mgyee/engn1600-team1/CAD5/README

### Group members
Matthias Yee, Alex Wang, Ray Wu, Martin Atilla, Kelvin Amankwaa

### Entire design workspace, including layouts and testbenches.
The main layout is `shifter.gds`. The main schematic is `shifter.sch`. We have four main testbenches:
- `shifter_tb.sch` for pre-PEX functionality checking
- `shifter_delay_tb.sch` for pre-PEX timing
- `shifter_postpex_tb.sch` for post-PEX functionality checking
- `shifter_postpex_delay_tb.sch` for post-PEX timing
In addition, we utilized the following testbench for sizing simulation: 
- `shifter_sizing_tb.sch`

### Testbenches
We used `generate.py` to convert a list of tests into input PWL stimuli. For output, we used Xschem graphs within the schematic to parse bus signals. Thus, we verify functionality using a more compact representation than per-input waveforms.

The results are in `SUBMIT/prepex/shifter_tb.svg` and `SUBMIT/postpex/shifter_postpex_tb.svg`. We simulate all shifts of `0x00AA` with resets in between to identify rise and fall time.

```
** TEST SUMMARY
** 00: 0x00AA << (0 ? 00 : 00) = 0x00AA
** 01: 0x00AA << (1 ? 00 : 00) = 0x00AA
** 02: 0x00AA << (0 ? 00 : 01) = 0x0154
** 03: 0x00AA << (1 ? 00 : 01) = 0x00AA
** 04: 0x00AA << (0 ? 00 : 02) = 0x02A8
** 05: 0x00AA << (1 ? 00 : 02) = 0x00AA
** 06: 0x00AA << (0 ? 00 : 03) = 0x0550
** 07: 0x00AA << (1 ? 00 : 03) = 0x00AA
** 08: 0x00AA << (0 ? 00 : 04) = 0x0AA0
** 09: 0x00AA << (1 ? 00 : 04) = 0x00AA
** 10: 0x00AA << (0 ? 00 : 05) = 0x1540
** 11: 0x00AA << (1 ? 00 : 05) = 0x00AA
** 12: 0x00AA << (0 ? 00 : 06) = 0x2A80
** 13: 0x00AA << (1 ? 00 : 06) = 0x00AA
** 14: 0x00AA << (0 ? 00 : 07) = 0x5500
** 15: 0x00AA << (1 ? 00 : 07) = 0x00AA
** 16: 0x00AA << (0 ? 00 : 08) = 0xAA00
** 17: 0x00AA << (1 ? 00 : 08) = 0x00AA
** 18: 0x00AA << (0 ? 00 : 09) = 0x5400
** 19: 0x00AA << (1 ? 00 : 09) = 0x00AA
** 20: 0x00AA << (0 ? 00 : 10) = 0xA800
** 21: 0x00AA << (1 ? 00 : 10) = 0x00AA
** 22: 0x00AA << (0 ? 00 : 11) = 0x5000
** 23: 0x00AA << (1 ? 00 : 11) = 0x00AA
** 24: 0x00AA << (0 ? 00 : 12) = 0xA000
** 25: 0x00AA << (1 ? 00 : 12) = 0x00AA
** 26: 0x00AA << (0 ? 00 : 13) = 0x4000
** 27: 0x00AA << (1 ? 00 : 13) = 0x00AA
** 28: 0x00AA << (0 ? 00 : 14) = 0x8000
** 29: 0x00AA << (1 ? 00 : 14) = 0x00AA
** 30: 0x00AA << (0 ? 00 : 15) = 0x0000
** 31: 0x00AA << (1 ? 00 : 15) = 0x00AA
```

See `SUBMIT/prepex/shifter_delay_tb.svg` or `SUBMIT/postpex/shifter_postpex_delay_tb.svg` for a demonstration of the critical path input we tested. In summary, we used an input whose critical path must traverse both R/I selection and all logarithmic shift stages before toggling the output. We tested both directions (rising and falling). In addition, `SUBMIT/prepex/shifter_delay.svg` monitors internal signals. Driving the SX lines takes a fair amount of time due to high capacitance.

```
** TEST SUMMARY
** 0x0001 << E -> 0x0001 << F -> 0x0001 << E
```

We get a pre-PEX rise time of **529.0 ps** and fall time of **541.4 ps**.

We get a post-PEX rise time of **1510.0 ps** and fall time of **1411.1 ps**.

The discrepancy likely arises since we did not simulate wire capacitance.

### Design
Before sizing, we tested four mux designs for the main shifter logic:

- Pure CMOS mux
- Pure CMOS mux with inversion between each stage (the design more naturally gives inverted outputs)
- Pure CMOX mux with inversion between each stage and gates to replace those with hardcoded inputs
- Transmission gate CMOS mux with inversion at the start and end for level restoration

The transmission gate variation was ultimately fastest and interfaces well with inverted RF inputs. Other designs suffered from high capacitance on the SX nodes.

For `S[3..0]` selection logic, we use a stack of 2x1 muxes to select between `R[3..0]` when SEL=0 and `I[3..0]` when SEL=1. We decided to use pure CMOS muxes instead of transmission gate muxes here since they are amenable to sizing and provide inverting outputs.

### Notes on sizing
- We just went with 1x sizing for `2x1_mux.sch`.
- Technically, we should size the S0, S1, S2, and S3 muxes differently since they lie later and later along the critical path, but we sized them together for simplicity.
- Ultimately, we iteratively sized kY, kYb = kI, and kSELb. kSELb is unbounded (the bigger the better) since we assert SEL without accounting for input capacitance. We limited kSELb to 6.
- To sweep sizes, we just exchanged the commenting on lines 326-329 of `shifter_sizing_tb.sch`.
- The testbench uses dummy transistors to estimate the load on each SX node.
