mgyee/engn1600-team1/CAD4/README

NB: We originally submitted what we had under Matthias. This submission is updated with the finalized layout and post-PEX analysis. I'll ask him to resubmit as well when he's available.

### Group members
Matthias Yee, Alex Wang, Ray Wu, Martin Atilla, Kelvin Amankwaa

### Entire design workspace, including layouts and testbenches.
The main layout is `alu.gds`. The main schematic is `alu.sch`. We have four main testbenches:
- `alu_tb.sch` for pre-PEX functionality checking
- `alu_delay_tb.sch` for pre-PEX timing
- `alu_postpex_tb.sch` for post-PEX functionality checking
- `alu_postpex_delay_tb.sch` for post-PEX timing

See `SUBMIT/ALU_main_drc.png`, `SUBMIT/ALU_antenna_drc.png`, and `SUBMIT/ALU_lvs.png` for DRC and LVS passing.

### Screenshots of at least the 6 tests mentioned in the Logic Verification section above.
We used `generate.py` to convert a list of tests into input PWL stimuli. For output, we used Xschem graphs within the schematic to parse bus signals. The results are in `SUBMIT/prepex/alu_tb.svg` and `SUBMIT/postpex/alu_postpex_tb.svg`.

### Screenshots of the simulated propagation delay.
See `SUBMIT/prepex/alu_delay_tb.svg` or `SUBMIT/postpex/alu_postpex_delay_tb.svg` for a demonstration of the inputs we tested. In summary, we used an input such that a change at the LSB of B would cause all COUTs to flip. We tested both directions (rising and falling). In addition, `SUBMIT/prepex/alu_delay.svg` monitors internal signals. Delay is roughly equal between FAs and MUXes.

We get a pre-PEX rise time of **1.748 ns** and fall time of **1.760 ns**.

We get a post-PEX rise time of **2.962 ns** and fall time of **3.016 ns**.

### A hand drawn drawing, annotating the critical path of this design.
See `SUBMIT/ENGN 1600 CAD4 CRIT.pdf`. With carry select, the critical path goes through the first set of full adders and then the 2x1 MUXes between subsequent 4-bit sets.
