mgyee/engn1600-team1/CAD3/SUBMIT/postpex/spice_rf_clk->we0clkdelay.png

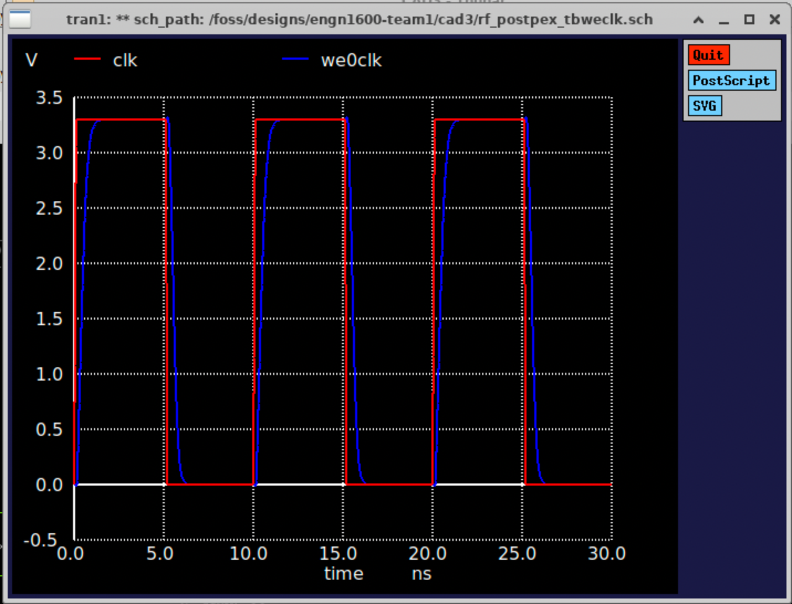
CAD3/SUBMIT/postpex/spice_rf_clk->we0clkdelay.png
