mgyee/engn1600-team1/CAD3/SUBMIT/RF_antenna_drc.png

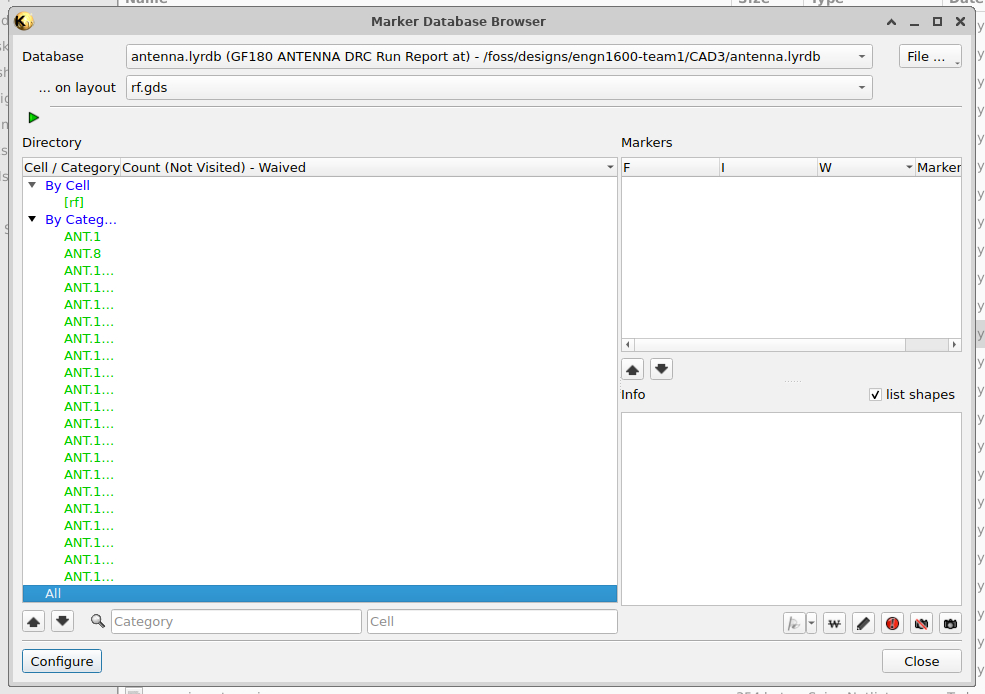
CAD3/SUBMIT/RF_antenna_drc.png
