mgyee/engn1600-team1/CAD3/SUBMIT/RF_lvs.png

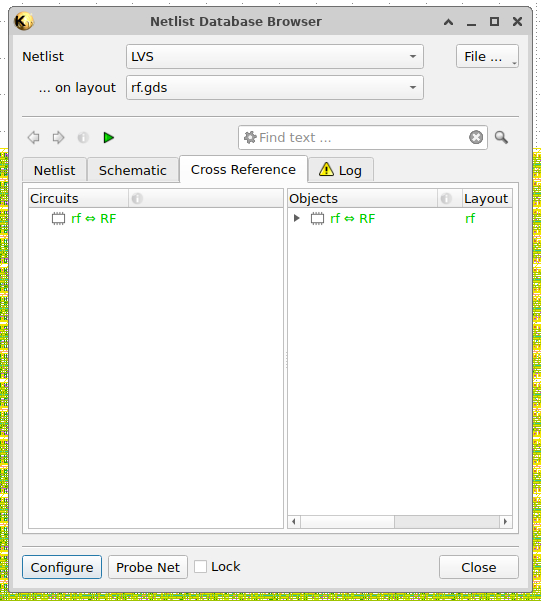
CAD3/SUBMIT/RF_lvs.png
