mgyee/engn1600-team1/CAD4/SUBMIT/ALU_antenna_drc.png

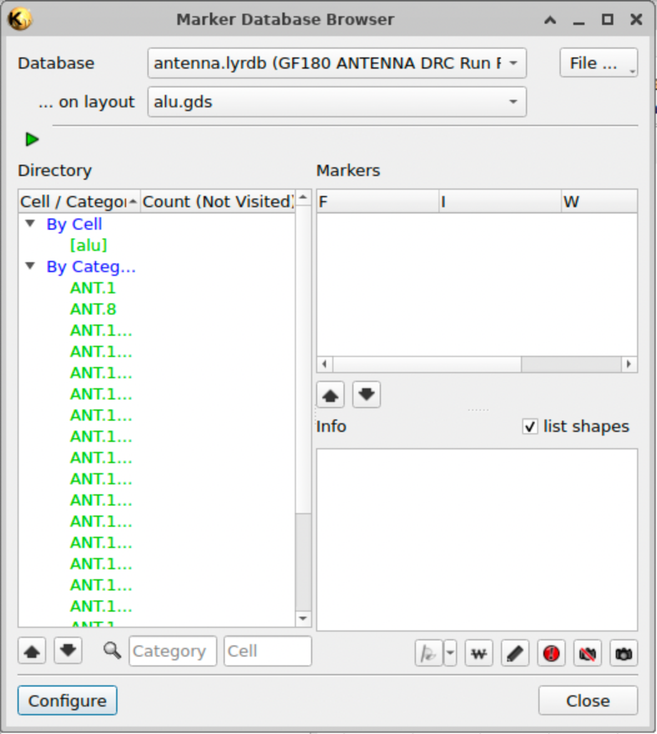
CAD4/SUBMIT/ALU_antenna_drc.png
