mgyee/engn1600-team1/CAD4/SUBMIT/ALU_lvs.png

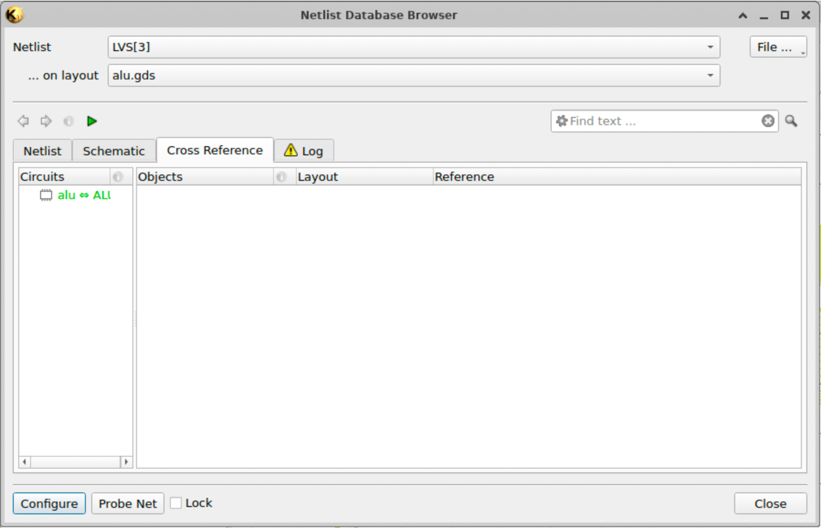
CAD4/SUBMIT/ALU_lvs.png
