mgyee/engn1600-team1/CAD5/SUBMIT/shifter_antenna_drc.png

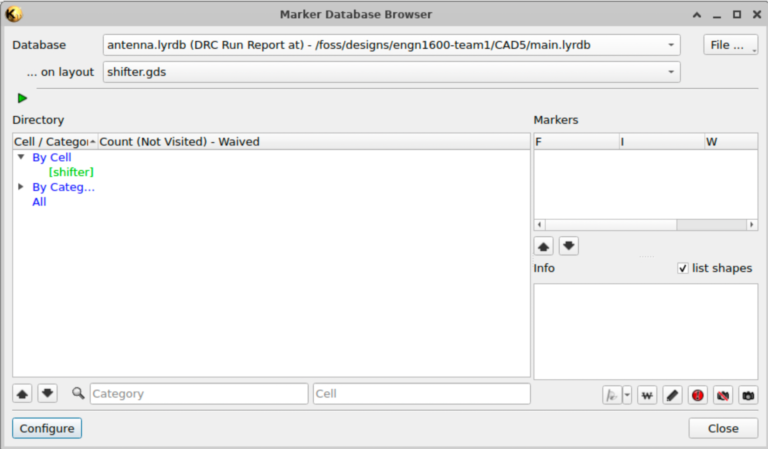
CAD5/SUBMIT/shifter_antenna_drc.png
