mgyee/engn1600-team1/CAD5/SUBMIT/shifter_lvs.png

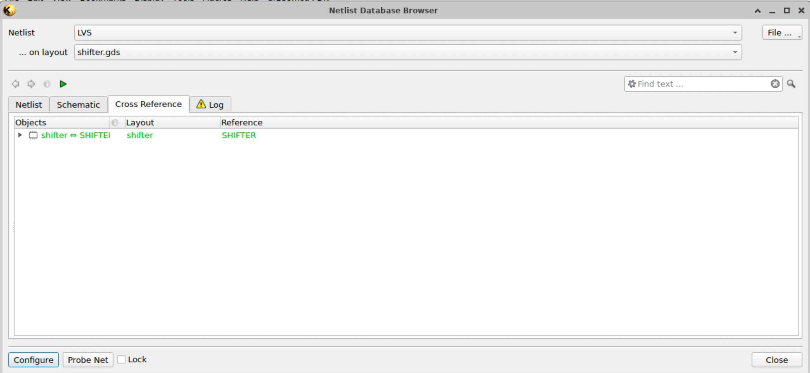
CAD5/SUBMIT/shifter_lvs.png
