mgyee/engn1600-team1/CAD6/SUBMIT/PC_lvs.png

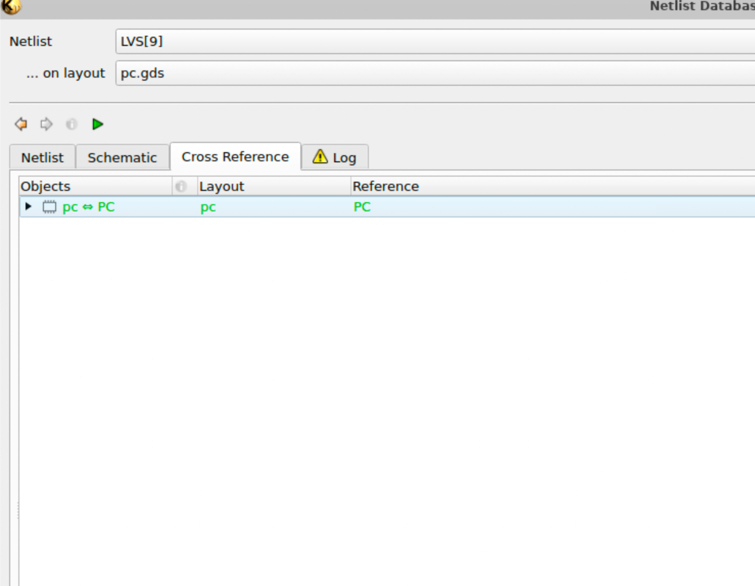
CAD6/SUBMIT/PC_lvs.png
