mgyee/engn1600-team1/media/alu_postpex_tb.png

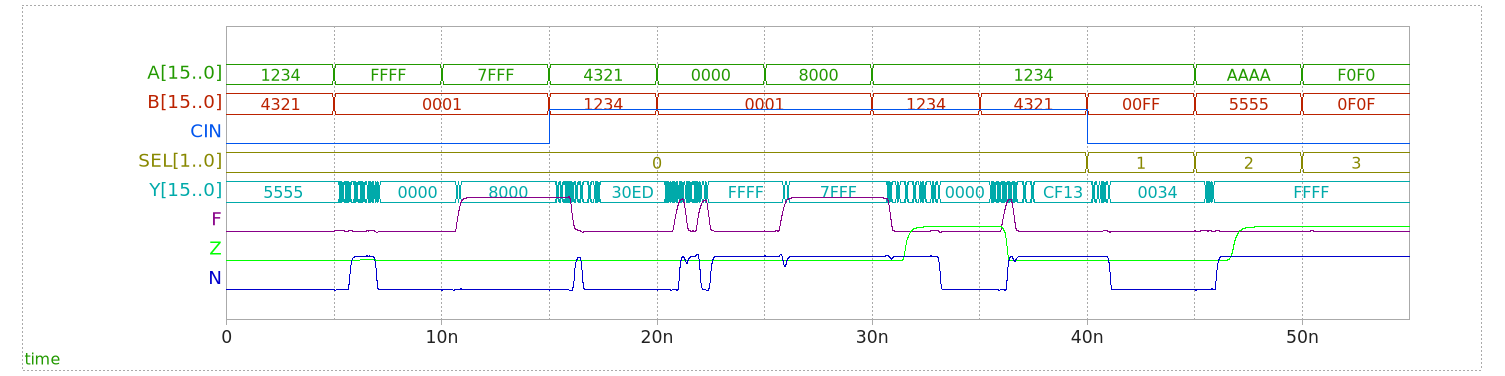
media/alu_postpex_tb.png
