mgyee/engn1600-team1/media/pc_postpex_tb.png

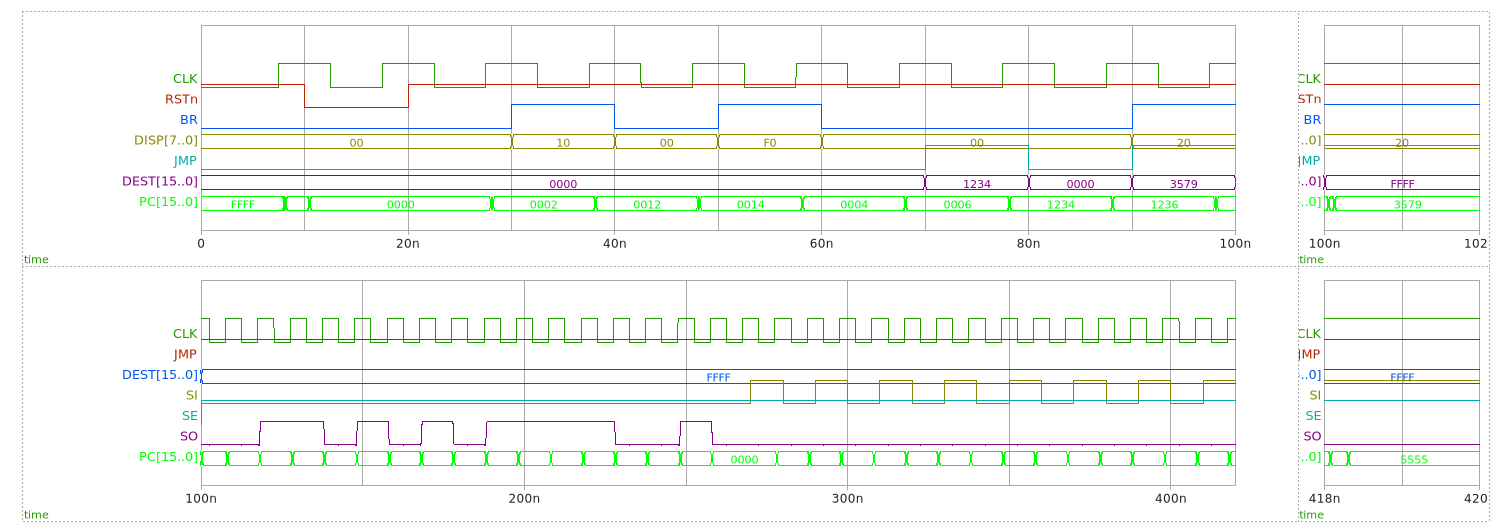
media/pc_postpex_tb.png
