mgyee/engn1600-team1/media/shifter_postpex_tb.png

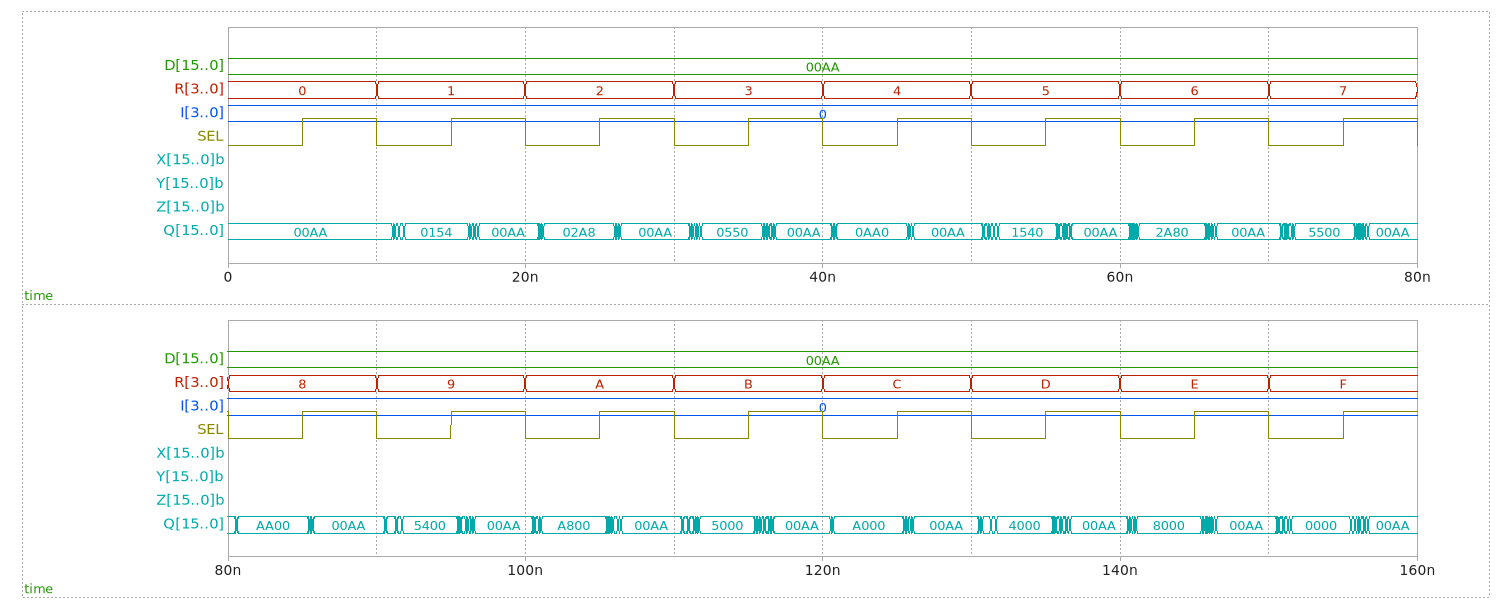
media/shifter_postpex_tb.png
