mgyee/engn1600-team1/CAD4/SUBMIT/ENGN 1600 CAD4 CRIT.pdf

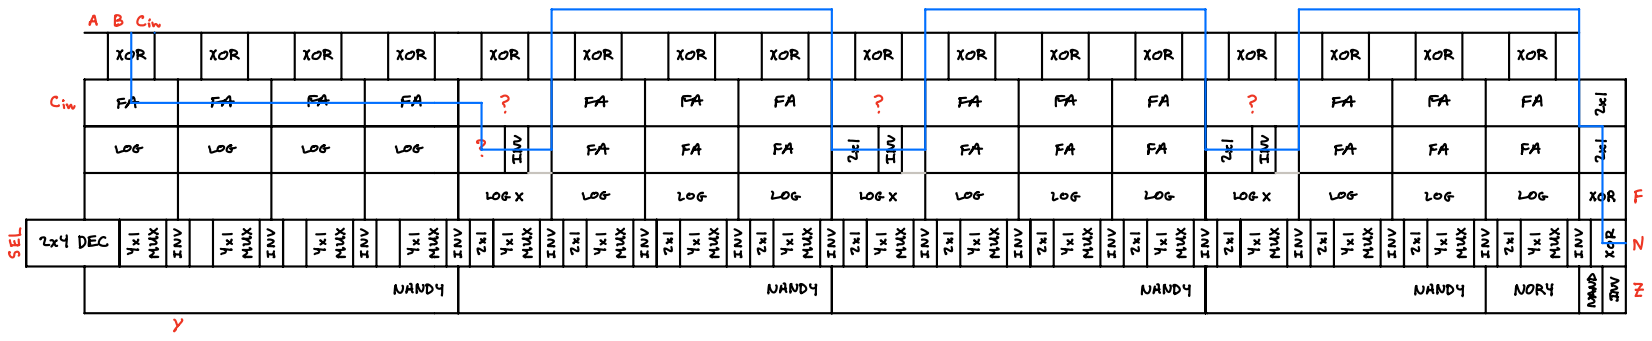
[picture p12: page 1]
SEL; neut; INV; iii; ILY or
