mgyee/engn1600-team1/CAD7/datapath_sim.spice

** sch_path: /foss/designs/engn1600-team1/CAD7/datapath.sch
**.subckt datapath RDST15,RDST14,RDST13,RDST12,RDST11,RDST10,RDST9,RDST8,RDST7,RDST6,RDST5,RDST4,RDST3,RDST2,RDST1,RDST0
*+ DMEM_ADDR15,DMEM_ADDR14,DMEM_ADDR13,DMEM_ADDR12,DMEM_ADDR11,DMEM_ADDR10,DMEM_ADDR9,DMEM_ADDR8,DMEM_ADDR7,DMEM_ADDR6,DMEM_ADDR5,DMEM_ADDR4,DMEM_ADDR3,DMEM_ADDR2,DMEM_ADDR1,DMEM_ADDR0
*+ DMEM_Q15,DMEM_Q14,DMEM_Q13,DMEM_Q12,DMEM_Q11,DMEM_Q10,DMEM_Q9,DMEM_Q8,DMEM_Q7,DMEM_Q6,DMEM_Q5,DMEM_Q4,DMEM_Q3,DMEM_Q2,DMEM_Q1,DMEM_Q0 ALU_SRC_B PC_BR REG_WRITE ALU_CIN WE15,WE14,WE13,WE12,WE11,WE10,WE9,WE8,WE7,WE6,WE5,WE4,WE3,WE2,WE1,WE0 ALU_F PC_JMP
*+ ALU_SEL1,ALU_SEL0 RA15,RA14,RA13,RA12,RA11,RA10,RA9,RA8,RA7,RA6,RA5,RA4,RA3,RA2,RA1,RA0
*+ RB15,RB14,RB13,RB12,RB11,RB10,RB9,RB8,RB7,RB6,RB5,RB4,RB3,RB2,RB1,RB0 ALU_Z ALU_N SI SE ALU_SRC_A CLK DATA_OUT3,DATA_OUT2,DATA_OUT1,DATA_OUT0 RSTn VSS
*+ INSTR15,INSTR14,INSTR13,INSTR12,INSTR11,INSTR10,INSTR9,INSTR8,INSTR7,INSTR6,INSTR5,INSTR4,INSTR3,INSTR2,INSTR1,INSTR0 VDD SHIFT_AMT_SRC IS_LUI
*+ IMEM_Q15,IMEM_Q14,IMEM_Q13,IMEM_Q12,IMEM_Q11,IMEM_Q10,IMEM_Q9,IMEM_Q8,IMEM_Q7,IMEM_Q6,IMEM_Q5,IMEM_Q4,IMEM_Q3,IMEM_Q2,IMEM_Q1,IMEM_Q0 PC15,PC14,PC13,PC12,PC11,PC10,PC9,PC8,PC7,PC6,PC5,PC4,PC3,PC2,PC1,PC0 EXTEND SHIFT_VAL_SRC
*.ipin RA15,RA14,RA13,RA12,RA11,RA10,RA9,RA8,RA7,RA6,RA5,RA4,RA3,RA2,RA1,RA0
*.ipin RB15,RB14,RB13,RB12,RB11,RB10,RB9,RB8,RB7,RB6,RB5,RB4,RB3,RB2,RB1,RB0
*.opin ALU_F
*.opin ALU_Z
*.opin ALU_N
*.opin RDST15,RDST14,RDST13,RDST12,RDST11,RDST10,RDST9,RDST8,RDST7,RDST6,RDST5,RDST4,RDST3,RDST2,RDST1,RDST0
*.ipin
*+ DMEM_Q15,DMEM_Q14,DMEM_Q13,DMEM_Q12,DMEM_Q11,DMEM_Q10,DMEM_Q9,DMEM_Q8,DMEM_Q7,DMEM_Q6,DMEM_Q5,DMEM_Q4,DMEM_Q3,DMEM_Q2,DMEM_Q1,DMEM_Q0
*.opin
*+ DMEM_ADDR15,DMEM_ADDR14,DMEM_ADDR13,DMEM_ADDR12,DMEM_ADDR11,DMEM_ADDR10,DMEM_ADDR9,DMEM_ADDR8,DMEM_ADDR7,DMEM_ADDR6,DMEM_ADDR5,DMEM_ADDR4,DMEM_ADDR3,DMEM_ADDR2,DMEM_ADDR1,DMEM_ADDR0
*.ipin WE15,WE14,WE13,WE12,WE11,WE10,WE9,WE8,WE7,WE6,WE5,WE4,WE3,WE2,WE1,WE0
*.opin PC15,PC14,PC13,PC12,PC11,PC10,PC9,PC8,PC7,PC6,PC5,PC4,PC3,PC2,PC1,PC0
*.ipin
*+ IMEM_Q15,IMEM_Q14,IMEM_Q13,IMEM_Q12,IMEM_Q11,IMEM_Q10,IMEM_Q9,IMEM_Q8,IMEM_Q7,IMEM_Q6,IMEM_Q5,IMEM_Q4,IMEM_Q3,IMEM_Q2,IMEM_Q1,IMEM_Q0
*.opin INSTR15,INSTR14,INSTR13,INSTR12,INSTR11,INSTR10,INSTR9,INSTR8,INSTR7,INSTR6,INSTR5,INSTR4,INSTR3,INSTR2,INSTR1,INSTR0
*.ipin ALU_SRC_B
*.ipin ALU_SRC_A
*.ipin IS_LUI
*.ipin SHIFT_VAL_SRC
*.ipin ALU_SEL1,ALU_SEL0
*.ipin REG_WRITE
*.ipin ALU_CIN
*.ipin PC_BR
*.ipin PC_JMP
*.ipin CLK
*.ipin RSTn
*.iopin VSS
*.iopin VDD
*.ipin EXTEND
*.ipin SHIFT_AMT_SRC
*.ipin SI
*.ipin SE
*.ipin DATA_OUT3,DATA_OUT2,DATA_OUT1,DATA_OUT0
xalu VDD VSS ALU_A15 ALU_A14 ALU_A13 ALU_A12 ALU_A11 ALU_A10 ALU_A9 ALU_A8 ALU_A7 ALU_A6 ALU_A5 ALU_A4 ALU_A3 ALU_A2 ALU_A1 ALU_A0
+ ALU_B15 ALU_B14 ALU_B13 ALU_B12 ALU_B11 ALU_B10 ALU_B9 ALU_B8 ALU_B7 ALU_B6 ALU_B5 ALU_B4 ALU_B3 ALU_B2 ALU_B1 ALU_B0 ALU_CIN ALU_SEL1
+ ALU_SEL0 ALU_Y15b ALU_Y14b ALU_Y13b ALU_Y12b ALU_Y11b ALU_Y10b ALU_Y9b ALU_Y8b ALU_Y7b ALU_Y6b ALU_Y5b ALU_Y4b ALU_Y3b ALU_Y2b ALU_Y1b
+ ALU_Y0b ALU_F ALU_Z ALU_N alu
xrf CLK WEM VDD VSS WE15 WE14 WE13 WE12 WE11 WE10 WE9 WE8 WE7 WE6 WE5 WE4 WE3 WE2 WE1 WE0 RA15 RA14 RA13 RA12 RA11 RA10 RA9 RA8
+ RA7 RA6 RA5 RA4 RA3 RA2 RA1 RA0 RB15 RB14 RB13 RB12 RB11 RB10 RB9 RB8 RB7 RB6 RB5 RB4 RB3 RB2 RB1 RB0 RF_D15 RF_D14 RF_D13 RF_D12
+ RF_D11 RF_D10 RF_D9 RF_D8 RF_D7 RF_D6 RF_D5 RF_D4 RF_D3 RF_D2 RF_D1 RF_D0 RSRC15b RSRC14b RSRC13b RSRC12b RSRC11b RSRC10b RSRC9b RSRC8b
+ RSRC7b RSRC6b RSRC5b RSRC4b RSRC3b RSRC2b RSRC1b RSRC0b RDST15b RDST14b RDST13b RDST12b RDST11b RDST10b RDST9b RDST8b RDST7b RDST6b
+ RDST5b RDST4b RDST3b RDST2b RDST1b RDST0b rf
xpc VDD VSS CLK RSTn PC_BR INSTR7 INSTR6 INSTR5 INSTR4 INSTR3 INSTR2 INSTR1 INSTR0 PC_JMP DEST15 DEST14 DEST13 DEST12 DEST11
+ DEST10 DEST9 DEST8 DEST7 DEST6 DEST5 DEST4 DEST3 DEST2 DEST1 SI SE PC15 PC14 PC13 PC12 PC11 PC10 PC9 PC8 PC7 PC6 PC5 PC4 PC3 PC2 PC1 PC0
+ PC_NEXT15 pc
xshifter VDD VSS SHIFTER_D15b SHIFTER_D14b SHIFTER_D13b SHIFTER_D12b SHIFTER_D11b SHIFTER_D10b SHIFTER_D9b SHIFTER_D8b SHIFTER_D7b
+ SHIFTER_D6b SHIFTER_D5b SHIFTER_D4b SHIFTER_D3b SHIFTER_D2b SHIFTER_D1b SHIFTER_D0b SHIFTER_I3 SHIFTER_I2 SHIFTER_I1 SHIFTER_I0 SHIFTER_R3
+ SHIFTER_R2 SHIFTER_R1 SHIFTER_R0 SHIFT_AMT_SRC SHIFTER_Q15b SHIFTER_Q14b SHIFTER_Q13b SHIFTER_Q12b SHIFTER_Q11b SHIFTER_Q10b SHIFTER_Q9b
+ SHIFTER_Q8b SHIFTER_Q7b SHIFTER_Q6b SHIFTER_Q5b SHIFTER_Q4b SHIFTER_Q3b SHIFTER_Q2b SHIFTER_Q1b SHIFTER_Q0b shifter
x515 DATA_OUT0 DMEM_Q15b DATA_OUT1 ALU_Y15b VSS net2[15] DATA_OUT2 SHIFTER_Q15b DATA_OUT3 VDD datapath_4x1_mux
x514 DATA_OUT0 DMEM_Q14b DATA_OUT1 ALU_Y14b VSS net2[14] DATA_OUT2 SHIFTER_Q14b DATA_OUT3 PC15b datapath_4x1_mux
x513 DATA_OUT0 DMEM_Q13b DATA_OUT1 ALU_Y13b VSS net2[13] DATA_OUT2 SHIFTER_Q13b DATA_OUT3 PC14b datapath_4x1_mux
x512 DATA_OUT0 DMEM_Q12b DATA_OUT1 ALU_Y12b VSS net2[12] DATA_OUT2 SHIFTER_Q12b DATA_OUT3 PC13b datapath_4x1_mux
x511 DATA_OUT0 DMEM_Q11b DATA_OUT1 ALU_Y11b VSS net2[11] DATA_OUT2 SHIFTER_Q11b DATA_OUT3 PC12b datapath_4x1_mux
x510 DATA_OUT0 DMEM_Q10b DATA_OUT1 ALU_Y10b VSS net2[10] DATA_OUT2 SHIFTER_Q10b DATA_OUT3 PC11b datapath_4x1_mux
x59 DATA_OUT0 DMEM_Q9b DATA_OUT1 ALU_Y9b VSS net2[9] DATA_OUT2 SHIFTER_Q9b DATA_OUT3 PC10b datapath_4x1_mux
x58 DATA_OUT0 DMEM_Q8b DATA_OUT1 ALU_Y8b VSS net2[8] DATA_OUT2 SHIFTER_Q8b DATA_OUT3 PC9b datapath_4x1_mux
x57 DATA_OUT0 DMEM_Q7b DATA_OUT1 ALU_Y7b VSS net2[7] DATA_OUT2 SHIFTER_Q7b DATA_OUT3 PC8b datapath_4x1_mux
x56 DATA_OUT0 DMEM_Q6b DATA_OUT1 ALU_Y6b VSS net2[6] DATA_OUT2 SHIFTER_Q6b DATA_OUT3 PC7b datapath_4x1_mux
x55 DATA_OUT0 DMEM_Q5b DATA_OUT1 ALU_Y5b VSS net2[5] DATA_OUT2 SHIFTER_Q5b DATA_OUT3 PC6b datapath_4x1_mux
x54 DATA_OUT0 DMEM_Q4b DATA_OUT1 ALU_Y4b VSS net2[4] DATA_OUT2 SHIFTER_Q4b DATA_OUT3 PC5b datapath_4x1_mux
x53 DATA_OUT0 DMEM_Q3b DATA_OUT1 ALU_Y3b VSS net2[3] DATA_OUT2 SHIFTER_Q3b DATA_OUT3 PC4b datapath_4x1_mux
x52 DATA_OUT0 DMEM_Q2b DATA_OUT1 ALU_Y2b VSS net2[2] DATA_OUT2 SHIFTER_Q2b DATA_OUT3 PC3b datapath_4x1_mux
x51 DATA_OUT0 DMEM_Q1b DATA_OUT1 ALU_Y1b VSS net2[1] DATA_OUT2 SHIFTER_Q1b DATA_OUT3 PC2b datapath_4x1_mux
x50 DATA_OUT0 DMEM_Q0b DATA_OUT1 ALU_Y0b VSS net2[0] DATA_OUT2 SHIFTER_Q0b DATA_OUT3 PC1b datapath_4x1_mux
x115 VDD net2[15] RF_D15 VSS datapath_inv kINV=1
x114 VDD net2[14] RF_D14 VSS datapath_inv kINV=1
x113 VDD net2[13] RF_D13 VSS datapath_inv kINV=1
x112 VDD net2[12] RF_D12 VSS datapath_inv kINV=1
x111 VDD net2[11] RF_D11 VSS datapath_inv kINV=1
x110 VDD net2[10] RF_D10 VSS datapath_inv kINV=1
x19 VDD net2[9] RF_D9 VSS datapath_inv kINV=1
x18 VDD net2[8] RF_D8 VSS datapath_inv kINV=1
x17 VDD net2[7] RF_D7 VSS datapath_inv kINV=1
x16 VDD net2[6] RF_D6 VSS datapath_inv kINV=1
x15 VDD net2[5] RF_D5 VSS datapath_inv kINV=1
x14 VDD net2[4] RF_D4 VSS datapath_inv kINV=1
x13 VDD net2[3] RF_D3 VSS datapath_inv kINV=1
x12 VDD net2[2] RF_D2 VSS datapath_inv kINV=1
x11 VDD net2[1] RF_D1 VSS datapath_inv kINV=1
x10 VDD net2[0] RF_D0 VSS datapath_inv kINV=1
x23 INSTR3 IS_LUI IS_LUI3b SHIFTER_I3 VDD VSS VDD datapath_2x1_mux
x22 INSTR2 IS_LUI IS_LUI2b SHIFTER_I2 VDD VSS VSS datapath_2x1_mux
x21 INSTR1 IS_LUI IS_LUI1b SHIFTER_I1 VDD VSS VSS datapath_2x1_mux
x20 INSTR0 IS_LUI IS_LUI0b SHIFTER_I0 VDD VSS VSS datapath_2x1_mux
x33 VDD RSRC3b SHIFTER_R3 VSS datapath_inv kINV=1
x32 VDD RSRC2b SHIFTER_R2 VSS datapath_inv kINV=1
x31 VDD RSRC1b SHIFTER_R1 VSS datapath_inv kINV=1
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
x190 VDD CLK CLK0b VSS datapath_inv kINV=1
x2015 VDD RDST15b RDST15 VSS datapath_inv kINV=1
x2014 VDD RDST14b RDST14 VSS datapath_inv kINV=1
x2013 VDD RDST13b RDST13 VSS datapath_inv kINV=1
x2012 VDD RDST12b RDST12 VSS datapath_inv kINV=1
x2011 VDD RDST11b RDST11 VSS datapath_inv kINV=1
x2010 VDD RDST10b RDST10 VSS datapath_inv kINV=1
x209 VDD RDST9b RDST9 VSS datapath_inv kINV=1
x208 VDD RDST8b RDST8 VSS datapath_inv kINV=1
x207 VDD RDST7b RDST7 VSS datapath_inv kINV=1
x206 VDD RDST6b RDST6 VSS datapath_inv kINV=1
x205 VDD RDST5b RDST5 VSS datapath_inv kINV=1
x204 VDD RDST4b RDST4 VSS datapath_inv kINV=1
x203 VDD RDST3b RDST3 VSS datapath_inv kINV=1
x202 VDD RDST2b RDST2 VSS datapath_inv kINV=1
x201 VDD RDST1b RDST1 VSS datapath_inv kINV=1
x200 VDD RDST0b RDST0 VSS datapath_inv kINV=1
x1 VDD net1 CLK16b REG_WRITE VSS datapath_nand2
x2 VDD net1 WEM VSS four_inv
**.ends

* expanding   symbol:  engn1600-team1/CAD4/alu.sym # of pins=10
** sym_path: /foss/designs/engn1600-team1/CAD4/alu.sym
** sch_path: /foss/designs/engn1600-team1/CAD4/alu.sch
.subckt alu VDD VSS A15 A14 A13 A12 A11 A10 A9 A8 A7 A6 A5 A4 A3 A2 A1 A0 B15 B14 B13 B12 B11 B10 B9 B8 B7 B6 B5 B4 B3 B2 B1 B0
+ CIN SEL1 SEL0 Y15b Y14b Y13b Y12b Y11b Y10b Y9b Y8b Y7b Y6b Y5b Y4b Y3b Y2b Y1b Y0b F Z N
*.iopin VDD
*.iopin VSS
*.ipin A15,A14,A13,A12,A11,A10,A9,A8,A7,A6,A5,A4,A3,A2,A1,A0
*.ipin B15,B14,B13,B12,B11,B10,B9,B8,B7,B6,B5,B4,B3,B2,B1,B0
*.ipin SEL1,SEL0
*.opin Y15b,Y14b,Y13b,Y12b,Y11b,Y10b,Y9b,Y8b,Y7b,Y6b,Y5b,Y4b,Y3b,Y2b,Y1b,Y0b
*.opin F
*.opin Z
*.opin N
*.ipin CIN
x1 VDD VSS A0 B0p CIN SUM0b COUT0 alu_full_adder kSUMb='kSUMb' kTS='kTS'
x2 VDD VSS A1 B1p COUT0 SUM1b COUT1 alu_full_adder kSUMb='kSUMb' kTS='kTS'
x3 VDD VSS A2 B2p COUT1 SUM2b COUT2 alu_full_adder kSUMb='kSUMb' kTS='kTS'
x4 VDD VSS A3 B3p COUT2 SUM3b COUT3 alu_full_adder kSUMb='kSUMb' kTS='kTS'
x5 NOR0 VDD VSS XNOR0 A0 B0p NAND0 XOR0 logic
x1015 SA SUM15b SB NAND15 VSS Y15b SC NOR15 SD XNOR15 alu_4x1_mux
x1014 SA SUM14b SB NAND14 VSS Y14b SC NOR14 SD XNOR14 alu_4x1_mux
x1013 SA SUM13b SB NAND13 VSS Y13b SC NOR13 SD XNOR13 alu_4x1_mux
x1012 SA SUM12b SB NAND12 VSS Y12b SC NOR12 SD XNOR12 alu_4x1_mux
x1011 SA SUM11b SB NAND11 VSS Y11b SC NOR11 SD XNOR11 alu_4x1_mux
x1010 SA SUM10b SB NAND10 VSS Y10b SC NOR10 SD XNOR10 alu_4x1_mux
x109 SA SUM9b SB NAND9 VSS Y9b SC NOR9 SD XNOR9 alu_4x1_mux
x108 SA SUM8b SB NAND8 VSS Y8b SC NOR8 SD XNOR8 alu_4x1_mux
x107 SA SUM7b SB NAND7 VSS Y7b SC NOR7 SD XNOR7 alu_4x1_mux
x106 SA SUM6b SB NAND6 VSS Y6b SC NOR6 SD XNOR6 alu_4x1_mux
x105 SA SUM5b SB NAND5 VSS Y5b SC NOR5 SD XNOR5 alu_4x1_mux
x104 SA SUM4b SB NAND4 VSS Y4b SC NOR4 SD XNOR4 alu_4x1_mux
x103 SA SUM3b SB NAND3 VSS Y3b SC NOR3 SD XNOR3 alu_4x1_mux
x102 SA SUM2b SB NAND2 VSS Y2b SC NOR2 SD XNOR2 alu_4x1_mux
x101 SA SUM1b SB NAND1 VSS Y1b SC NOR1 SD XNOR1 alu_4x1_mux
x100 SA SUM0b SB NAND0 VSS Y0b SC NOR0 SD XNOR0 alu_4x1_mux
x6 VDD Y15b Y15 VSS alu_inv
x8 NOR1 VDD VSS XNOR1 A1 B1p NAND1 XOR1 logic
x11 NOR2 VDD VSS XNOR2 A2 B2p NAND2 XOR2 logic
x14 NOR3 VDD VSS XNOR3 A3 B3p NAND3 XOR3 logic
x17 AND4 XOR4 OR4 NOR4 VDD VSS XNOR4 A4 B4p NAND4 logic_extended
x18 VDD VSS A5 B5p AND4 SUM_05b COUT_05 alu_full_adder kSUMb='kSUMb' kTS='kTS'
x19 VDD VSS A6 B6p COUT_05 SUM_06b COUT_06 alu_full_adder kSUMb='kSUMb' kTS='kTS'
x20 VDD VSS A7 B7p COUT_06 SUM_07b COUT_07 alu_full_adder kSUMb='kSUMb' kTS='kTS'
x24 NOR5 VDD VSS XNOR5 A5 B5p NAND5 XOR5 logic
x25 NOR6 VDD VSS XNOR6 A6 B6p NAND6 XOR6 logic
x26 NOR7 VDD VSS XNOR7 A7 B7p NAND7 XOR7 logic
x35 SUM_07b COUT3 COUT3b SUM7b VDD VSS SUM_17b alu_2x1_mux
x36 SUM_06b COUT3 COUT3b SUM6b VDD VSS SUM_16b alu_2x1_mux
x37 SUM_05b COUT3 COUT3b SUM5b VDD VSS SUM_15b alu_2x1_mux
x38 XOR4 COUT3b COUT3 SUM4b VDD VSS XNOR4 alu_2x1_mux
x21 VDD VSS A5 B5p OR4 SUM_15b COUT_15 alu_full_adder kSUMb='kSUMb' kTS='kTS'
x22 VDD VSS A6 B6p COUT_15 SUM_16b COUT_16 alu_full_adder kSUMb='kSUMb' kTS='kTS'
x23 VDD VSS A7 B7p COUT_16 SUM_17b COUT_17 alu_full_adder kSUMb='kSUMb' kTS='kTS'
x39 COUT_17 COUT3b COUT3 COUT7 VDD VSS COUT_07 COUT7b alu_2x1_mux_cmos kI='kI' kYb='kYb' kY='kY'
x40 VDD COUT3 COUT3b VSS alu_inv
x42 AND8 XOR8 OR8 NOR8 VDD VSS XNOR8 A8 B8p NAND8 logic_extended
x43 VDD VSS A9 B9p AND8 SUM_09b COUT_09 alu_full_adder kSUMb='kSUMb' kTS='kTS'
x44 VDD VSS A10 B10p COUT_09 SUM_010b COUT_010 alu_full_adder kSUMb='kSUMb' kTS='kTS'
x45 VDD VSS A11 B11p COUT_010 SUM_011b COUT_011 alu_full_adder kSUMb='kSUMb' kTS='kTS'
x46 NOR9 VDD VSS XNOR9 A9 B9p NAND9 XOR9 logic
x47 NOR10 VDD VSS XNOR10 A10 B10p NAND10 XOR10 logic
x48 NOR11 VDD VSS XNOR11 A11 B11p NAND11 XOR11 logic
x57 SUM_011b COUT7 COUT7b SUM11b VDD VSS SUM_111b alu_2x1_mux
x58 SUM_010b COUT7 COUT7b SUM10b VDD VSS SUM_110b alu_2x1_mux
x59 SUM_09b COUT7 COUT7b SUM9b VDD VSS SUM_19b alu_2x1_mux
x60 XOR8 COUT7b COUT7 SUM8b VDD VSS XNOR8 alu_2x1_mux
x61 VDD VSS A9 B9p OR8 SUM_19b COUT_19 alu_full_adder kSUMb='kSUMb' kTS='kTS'
x62 VDD VSS A10 B10p COUT_19 SUM_110b COUT_110 alu_full_adder kSUMb='kSUMb' kTS='kTS'
x63 VDD VSS A11 B11p COUT_110 SUM_111b COUT_111 alu_full_adder kSUMb='kSUMb' kTS='kTS'
x64 COUT_111 COUT7b COUT7 COUT11 VDD VSS COUT_011 COUT11b alu_2x1_mux_cmos kI='kI' kYb='kYb' kY='kY'
x66 AND12 XOR12 OR12 NOR12 VDD VSS XNOR12 A12 B12p NAND12 logic_extended
x67 VDD VSS A13 B13p AND12 SUM_013b COUT_013 alu_full_adder kSUMb='kSUMb' kTS='kTS'
x68 VDD VSS A14 B14p COUT_013 SUM_014b COUT_014 alu_full_adder kSUMb='kSUMb' kTS='kTS'
x69 VDD VSS A15 B15p COUT_014 SUM_015b COUT_015 alu_full_adder kSUMb='kSUMb' kTS='kTS'
x70 NOR13 VDD VSS XNOR13 A13 B13p NAND13 XOR13 logic
x71 NOR14 VDD VSS XNOR14 A14 B14p NAND14 XOR14 logic
x72 NOR15 VDD VSS XNOR15 A15 B15p NAND15 XOR15 logic
x81 SUM_015b COUT11 COUT11b SUM15b VDD VSS SUM_115b alu_2x1_mux
x82 SUM_014b COUT11 COUT11b SUM14b VDD VSS SUM_114b alu_2x1_mux
x83 SUM_013b COUT11 COUT11b SUM13b VDD VSS SUM_113b alu_2x1_mux
x84 XOR12 COUT11b COUT11 SUM12b VDD VSS XNOR12 alu_2x1_mux
x85 VDD VSS A13 B13p OR12 SUM_113b COUT_113 alu_full_adder kSUMb='kSUMb' kTS='kTS'
x86 VDD VSS A14 B14p COUT_113 SUM_114b COUT_114 alu_full_adder kSUMb='kSUMb' kTS='kTS'
x87 VDD VSS A15 B15p COUT_114 SUM_115b COUT_115 alu_full_adder kSUMb='kSUMb' kTS='kTS'
x88 VDD VSS SEL0 SEL1 SA SB SC SD 2x4_decoder
x89 XOR15 XOR14 XOR13 XOR12 XOR11 XOR10 XOR9 XOR8 XOR7 XOR6 XOR5 XOR4 XOR3 XOR2 XOR1 XOR0 VDD Z VSS and16
x91 COUT_115 COUT11b COUT11 COUT15 VDD VSS COUT_015 COUT15b alu_2x1_mux_cmos kI='kI' kYb='kYb' kY='kY'
x94 COUT_014 COUT11 COUT11b COUT14 VDD VSS COUT_114 COUT14b alu_2x1_mux_cmos kI='kI' kYb='kYb' kY='kY'
x93 VDD F COUT14 COUT15 VSS xor2
x95 VDD N F Y15 VSS xor2
x1215 VDD B15p B15 CIN VSS xor2
x1214 VDD B14p B14 CIN VSS xor2
x1213 VDD B13p B13 CIN VSS xor2
x1212 VDD B12p B12 CIN VSS xor2
x1211 VDD B11p B11 CIN VSS xor2
x1210 VDD B10p B10 CIN VSS xor2
x129 VDD B9p B9 CIN VSS xor2
x128 VDD B8p B8 CIN VSS xor2
x127 VDD B7p B7 CIN VSS xor2
x126 VDD B6p B6 CIN VSS xor2
x125 VDD B5p B5 CIN VSS xor2
x124 VDD B4p B4 CIN VSS xor2
x123 VDD B3p B3 CIN VSS xor2
x122 VDD B2p B2 CIN VSS xor2
x121 VDD B1p B1 CIN VSS xor2
x120 VDD B0p B0 CIN VSS xor2
**** begin user architecture code


.param kSUMb=1
.param kTS=1
.param kI=2.5
.param kYb=1.875
.param kY=0.775/0.36


**** end user architecture code
.ends
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
