mgyee/engn1600-team1/CAD7/datapath.spice

.subckt datapath RDST15 RDST14 RDST13 RDST12 RDST11 RDST10 RDST9 RDST8 RDST7 RDST6 RDST5 RDST4 RDST3 RDST2 RDST1 RDST0 DMEM_ADDR15 DMEM_ADDR14 DMEM_ADDR13 DMEM_ADDR12 DMEM_ADDR11 DMEM_ADDR10 DMEM_ADDR9 DMEM_ADDR8 DMEM_ADDR7 DMEM_ADDR6 DMEM_ADDR5 DMEM_ADDR4 DMEM_ADDR3 DMEM_ADDR2 DMEM_ADDR1 DMEM_ADDR0 DMEM_Q15 DMEM_Q14 DMEM_Q13 DMEM_Q12 DMEM_Q11 DMEM_Q10 DMEM_Q9 DMEM_Q8 DMEM_Q7 DMEM_Q6 DMEM_Q5 DMEM_Q4 DMEM_Q3 DMEM_Q2 DMEM_Q1 DMEM_Q0 ALU_SRC_B PC_BR REG_WRITE ALU_CIN WE15 WE14 WE13 WE12 WE11 WE10 WE9 WE8 WE7 WE6 WE5 WE4 WE3 WE2 WE1 WE0 ALU_F PC_JMP ALU_SEL1 ALU_SEL0 RA15 RA14 RA13 RA12 RA11 RA10 RA9 RA8 RA7 RA6 RA5 RA4 RA3 RA2 RA1 RA0 RB15 RB14 RB13 RB12 RB11 RB10 RB9 RB8 RB7 RB6 RB5 RB4 RB3 RB2 RB1 RB0 ALU_Z ALU_N SI SE ALU_SRC_A CLK DATA_OUT3 DATA_OUT2 DATA_OUT1 DATA_OUT0 RSTn VSS INSTR15 INSTR14 INSTR13 INSTR12 INSTR11 INSTR10 INSTR9 INSTR8 INSTR7 INSTR6 INSTR5 INSTR4 INSTR3 INSTR2 INSTR1 INSTR0 VDD SHIFT_AMT_SRC IS_LUI IMEM_Q15 IMEM_Q14 IMEM_Q13 IMEM_Q12 IMEM_Q11 IMEM_Q10 IMEM_Q9 IMEM_Q8 IMEM_Q7 IMEM_Q6 IMEM_Q5 IMEM_Q4 IMEM_Q3 IMEM_Q2 IMEM_Q1 IMEM_Q0 PC15 PC14 PC13 PC12 PC11 PC10 PC9 PC8 PC7 PC6 PC5 PC4 PC3 PC2 PC1 PC0 EXTEND SHIFT_VAL_SRC
*.PININFO RA[15..0]:I RB[15..0]:I ALU_F:O ALU_Z:O ALU_N:O RDST[15..0]:O DMEM_Q[15..0]:I DMEM_ADDR[15..0]:O WE[15..0]:I PC[15..0]:O
*+ IMEM_Q[15..0]:I INSTR[15..0]:O ALU_SRC_B:I ALU_SRC_A:I IS_LUI:I SHIFT_VAL_SRC:I ALU_SEL[1..0]:I REG_WRITE:I ALU_CIN:I PC_BR:I PC_JMP:I CLK:I
*+ RSTn:I VSS:B VDD:B EXTEND:I SHIFT_AMT_SRC:I SI:I SE:I DATA_OUT[3..0]:I
xalu VDD VSS ALU_A15 ALU_A14 ALU_A13 ALU_A12 ALU_A11 ALU_A10 ALU_A9 ALU_A8 ALU_A7 ALU_A6 ALU_A5 ALU_A4 ALU_A3 ALU_A2 ALU_A1 ALU_A0 ALU_B15 ALU_B14 ALU_B13 ALU_B12 ALU_B11 ALU_B10 ALU_B9 ALU_B8 ALU_B7 ALU_B6 ALU_B5 ALU_B4 ALU_B3 ALU_B2 ALU_B1 ALU_B0 ALU_CIN ALU_SEL1 ALU_SEL0 ALU_Y15b ALU_Y14b ALU_Y13b ALU_Y12b ALU_Y11b ALU_Y10b ALU_Y9b ALU_Y8b ALU_Y7b ALU_Y6b ALU_Y5b ALU_Y4b ALU_Y3b ALU_Y2b ALU_Y1b ALU_Y0b ALU_F ALU_Z ALU_N alu_kI_2p5_kSUMb_1_kTS_1_kY_2p15278_kYb_1p875
xrf CLK WEM VDD VSS WE15 WE14 WE13 WE12 WE11 WE10 WE9 WE8 WE7 WE6 WE5 WE4 WE3 WE2 WE1 WE0 RA15 RA14 RA13 RA12 RA11 RA10 RA9 RA8 RA7 RA6 RA5 RA4 RA3 RA2 RA1 RA0 RB15 RB14 RB13 RB12 RB11 RB10 RB9 RB8 RB7 RB6 RB5 RB4 RB3 RB2 RB1 RB0 RF_D15 RF_D14 RF_D13 RF_D12 RF_D11 RF_D10 RF_D9 RF_D8 RF_D7 RF_D6 RF_D5 RF_D4 RF_D3 RF_D2 RF_D1 RF_D0 RSRC15b RSRC14b RSRC13b RSRC12b RSRC11b RSRC10b RSRC9b RSRC8b RSRC7b RSRC6b RSRC5b RSRC4b RSRC3b RSRC2b RSRC1b RSRC0b RDST15b RDST14b RDST13b RDST12b RDST11b RDST10b RDST9b RDST8b RDST7b RDST6b RDST5b RDST4b RDST3b RDST2b RDST1b RDST0b rf_kN_3p44444_kQ_1_kWECLK_3p52778_kWECLKb_3p72222_kWEMb_3p5
xpc VDD VSS CLK RSTn PC_BR INSTR7 INSTR6 INSTR5 INSTR4 INSTR3 INSTR2 INSTR1 INSTR0 PC_JMP DEST15 DEST14 DEST13 DEST12 DEST11 DEST10 DEST9 DEST8 DEST7 DEST6 DEST5 DEST4 DEST3 DEST2 DEST1 SI SE PC15 PC14 PC13 PC12 PC11 PC10 PC9 PC8 PC7 PC6 PC5 PC4 PC3 PC2 PC1 PC0 PC_NEXT15 pc_Kb_1_kINV_1_kSUMb_1_kTS_1
xshifter VDD VSS SHIFTER_D15b SHIFTER_D14b SHIFTER_D13b SHIFTER_D12b SHIFTER_D11b SHIFTER_D10b SHIFTER_D9b SHIFTER_D8b SHIFTER_D7b SHIFTER_D6b SHIFTER_D5b SHIFTER_D4b SHIFTER_D3b SHIFTER_D2b SHIFTER_D1b SHIFTER_D0b SHIFTER_I3 SHIFTER_I2 SHIFTER_I1 SHIFTER_I0 SHIFTER_R3 SHIFTER_R2 SHIFTER_R1 SHIFTER_R0 SHIFT_AMT_SRC SHIFTER_Q15b SHIFTER_Q14b SHIFTER_Q13b SHIFTER_Q12b SHIFTER_Q11b SHIFTER_Q10b SHIFTER_Q9b SHIFTER_Q8b SHIFTER_Q7b SHIFTER_Q6b SHIFTER_Q5b SHIFTER_Q4b SHIFTER_Q3b SHIFTER_Q2b SHIFTER_Q1b SHIFTER_Q0b shifter_kI_6p95833_kSELb_6_kY_7p25_kYb_6p95833
x515 DATA_OUT0 DMEM_Q15b DATA_OUT1 ALU_Y15b VSS net2[15] DATA_OUT2 SHIFTER_Q15b DATA_OUT3 VDD datapath_4x1_mux
x514 DATA_OUT0 DMEM_Q14b DATA_OUT1 ALU_Y14b VSS net2[14] DATA_OUT2 SHIFTER_Q14b DATA_OUT3 PC15b datapath_4x1_mux
x513 DATA_OUT0 DMEM_Q13b DATA_OUT1 ALU_Y13b VSS net2[13] DATA_OUT2 SHIFTER_Q13b DATA_OUT3 PC14b datapath_4x1_mux
x512 DATA_OUT0 DMEM_Q12b DATA_OUT1 ALU_Y12b VSS net2[12] DATA_OUT2 SHIFTER_Q12b DATA_OUT3 PC13b datapath_4x1_mux
x511 DATA_OUT0 DMEM_Q11b DATA_OUT1 ALU_Y11b VSS net2[11] DATA_OUT2 SHIFTER_Q11b DATA_OUT3 PC12b datapath_4x1_mux
x510 DATA_OUT0 DMEM_Q10b DATA_OUT1 ALU_Y10b VSS net2[10] DATA_OUT2 SHIFTER_Q10b DATA_OUT3 PC11b datapath_4x1_mux
x59 DATA_OUT0 DMEM_Q9b DATA_OUT1 ALU_Y9b VSS net2[9] DATA_OUT2 SHIFTER_Q9b DATA_OUT3 PC10b datapath_4x1_mux
x58 DATA_OUT0 DMEM_Q8b DATA_OUT1 ALU_Y8b VSS net2[8] DATA_OUT2 SHIFTER_Q8b DATA_OUT3 PC9b datapath_4x1_mux
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
x203 VDD RDST3b RDST3 VSS datapath_inv_kINV_1
x202 VDD RDST2b RDST2 VSS datapath_inv_kINV_1
x201 VDD RDST1b RDST1 VSS datapath_inv_kINV_1
x200 VDD RDST0b RDST0 VSS datapath_inv_kINV_1
x1 VDD net1 CLK16b REG_WRITE VSS datapath_nand2
x2 VDD net1 WEM VSS four_inv
.ends

.subckt alu_kI_2p5_kSUMb_1_kTS_1_kY_2p15278_kYb_1p875 VDD VSS A15 A14 A13 A12 A11 A10 A9 A8 A7 A6 A5 A4 A3 A2 A1 A0 B15 B14 B13 B12 B11 B10 B9 B8 B7 B6 B5 B4 B3 B2 B1 B0 CIN SEL1 SEL0 Y15b Y14b Y13b Y12b Y11b Y10b Y9b Y8b Y7b Y6b Y5b Y4b Y3b Y2b Y1b Y0b F Z N
*.PININFO VDD:B VSS:B A[15..0]:I B[15..0]:I SEL[1..0]:I Y[15..0]b:O F:O Z:O N:O CIN:I
x1 VDD VSS A0 B0p CIN SUM0b COUT0 alu_full_adder_kSUMb_1_kTS_1
x2 VDD VSS A1 B1p COUT0 SUM1b COUT1 alu_full_adder_kSUMb_1_kTS_1
x3 VDD VSS A2 B2p COUT1 SUM2b COUT2 alu_full_adder_kSUMb_1_kTS_1
x4 VDD VSS A3 B3p COUT2 SUM3b COUT3 alu_full_adder_kSUMb_1_kTS_1
x5 NOR0 VDD VSS XNOR0 A0 B0p NAND0 XOR0 logic
x1015 SA SUM15b SB NAND15 VSS Y15b SC NOR15 SD XNOR15 alu_4x1_mux
x1014 SA SUM14b SB NAND14 VSS Y14b SC NOR14 SD XNOR14 alu_4x1_mux
x1013 SA SUM13b SB NAND13 VSS Y13b SC NOR13 SD XNOR13 alu_4x1_mux
x1012 SA SUM12b SB NAND12 VSS Y12b SC NOR12 SD XNOR12 alu_4x1_mux
x1011 SA SUM11b SB NAND11 VSS Y11b SC NOR11 SD XNOR11 alu_4x1_mux
x1010 SA SUM10b SB NAND10 VSS Y10b SC NOR10 SD XNOR10 alu_4x1_mux
x109 SA SUM9b SB NAND9 VSS Y9b SC NOR9 SD XNOR9 alu_4x1_mux
x108 SA SUM8b SB NAND8 VSS Y8b SC NOR8 SD XNOR8 alu_4x1_mux
x107 SA SUM7b SB NAND7 VSS Y7b SC NOR7 SD XNOR7 alu_4x1_mux
x106 SA SUM6b SB NAND6 VSS Y6b SC NOR6 SD XNOR6 alu_4x1_mux
x105 SA SUM5b SB NAND5 VSS Y5b SC NOR5 SD XNOR5 alu_4x1_mux
x104 SA SUM4b SB NAND4 VSS Y4b SC NOR4 SD XNOR4 alu_4x1_mux
x103 SA SUM3b SB NAND3 VSS Y3b SC NOR3 SD XNOR3 alu_4x1_mux
x102 SA SUM2b SB NAND2 VSS Y2b SC NOR2 SD XNOR2 alu_4x1_mux
x101 SA SUM1b SB NAND1 VSS Y1b SC NOR1 SD XNOR1 alu_4x1_mux
x100 SA SUM0b SB NAND0 VSS Y0b SC NOR0 SD XNOR0 alu_4x1_mux
x6 VDD Y15b Y15 VSS alu_inv
x8 NOR1 VDD VSS XNOR1 A1 B1p NAND1 XOR1 logic
x11 NOR2 VDD VSS XNOR2 A2 B2p NAND2 XOR2 logic
x14 NOR3 VDD VSS XNOR3 A3 B3p NAND3 XOR3 logic
x17 AND4 XOR4 OR4 NOR4 VDD VSS XNOR4 A4 B4p NAND4 logic_extended
x18 VDD VSS A5 B5p AND4 SUM_05b COUT_05 alu_full_adder_kSUMb_1_kTS_1
x19 VDD VSS A6 B6p COUT_05 SUM_06b COUT_06 alu_full_adder_kSUMb_1_kTS_1
x20 VDD VSS A7 B7p COUT_06 SUM_07b COUT_07 alu_full_adder_kSUMb_1_kTS_1
x24 NOR5 VDD VSS XNOR5 A5 B5p NAND5 XOR5 logic
x25 NOR6 VDD VSS XNOR6 A6 B6p NAND6 XOR6 logic
x26 NOR7 VDD VSS XNOR7 A7 B7p NAND7 XOR7 logic
x35 SUM_07b COUT3 COUT3b SUM7b VDD VSS SUM_17b alu_2x1_mux
x36 SUM_06b COUT3 COUT3b SUM6b VDD VSS SUM_16b alu_2x1_mux
x37 SUM_05b COUT3 COUT3b SUM5b VDD VSS SUM_15b alu_2x1_mux
x38 XOR4 COUT3b COUT3 SUM4b VDD VSS XNOR4 alu_2x1_mux
x21 VDD VSS A5 B5p OR4 SUM_15b COUT_15 alu_full_adder_kSUMb_1_kTS_1
x22 VDD VSS A6 B6p COUT_15 SUM_16b COUT_16 alu_full_adder_kSUMb_1_kTS_1
x23 VDD VSS A7 B7p COUT_16 SUM_17b COUT_17 alu_full_adder_kSUMb_1_kTS_1
x39 COUT_17 COUT3b COUT3 COUT7 VDD VSS COUT_07 COUT7b alu_2x1_mux_cmos_kI_2p5_kY_2p15278_kYb_1p875
x40 VDD COUT3 COUT3b VSS alu_inv
x42 AND8 XOR8 OR8 NOR8 VDD VSS XNOR8 A8 B8p NAND8 logic_extended
x43 VDD VSS A9 B9p AND8 SUM_09b COUT_09 alu_full_adder_kSUMb_1_kTS_1
x44 VDD VSS A10 B10p COUT_09 SUM_010b COUT_010 alu_full_adder_kSUMb_1_kTS_1
x45 VDD VSS A11 B11p COUT_010 SUM_011b COUT_011 alu_full_adder_kSUMb_1_kTS_1
x46 NOR9 VDD VSS XNOR9 A9 B9p NAND9 XOR9 logic
x47 NOR10 VDD VSS XNOR10 A10 B10p NAND10 XOR10 logic
x48 NOR11 VDD VSS XNOR11 A11 B11p NAND11 XOR11 logic
x57 SUM_011b COUT7 COUT7b SUM11b VDD VSS SUM_111b alu_2x1_mux
x58 SUM_010b COUT7 COUT7b SUM10b VDD VSS SUM_110b alu_2x1_mux
x59 SUM_09b COUT7 COUT7b SUM9b VDD VSS SUM_19b alu_2x1_mux
x60 XOR8 COUT7b COUT7 SUM8b VDD VSS XNOR8 alu_2x1_mux
x61 VDD VSS A9 B9p OR8 SUM_19b COUT_19 alu_full_adder_kSUMb_1_kTS_1
x62 VDD VSS A10 B10p COUT_19 SUM_110b COUT_110 alu_full_adder_kSUMb_1_kTS_1
x63 VDD VSS A11 B11p COUT_110 SUM_111b COUT_111 alu_full_adder_kSUMb_1_kTS_1
x64 COUT_111 COUT7b COUT7 COUT11 VDD VSS COUT_011 COUT11b alu_2x1_mux_cmos_kI_2p5_kY_2p15278_kYb_1p875
x66 AND12 XOR12 OR12 NOR12 VDD VSS XNOR12 A12 B12p NAND12 logic_extended
x67 VDD VSS A13 B13p AND12 SUM_013b COUT_013 alu_full_adder_kSUMb_1_kTS_1
x68 VDD VSS A14 B14p COUT_013 SUM_014b COUT_014 alu_full_adder_kSUMb_1_kTS_1
x69 VDD VSS A15 B15p COUT_014 SUM_015b COUT_015 alu_full_adder_kSUMb_1_kTS_1
x70 NOR13 VDD VSS XNOR13 A13 B13p NAND13 XOR13 logic
x71 NOR14 VDD VSS XNOR14 A14 B14p NAND14 XOR14 logic
x72 NOR15 VDD VSS XNOR15 A15 B15p NAND15 XOR15 logic
x81 SUM_015b COUT11 COUT11b SUM15b VDD VSS SUM_115b alu_2x1_mux
x82 SUM_014b COUT11 COUT11b SUM14b VDD VSS SUM_114b alu_2x1_mux
x83 SUM_013b COUT11 COUT11b SUM13b VDD VSS SUM_113b alu_2x1_mux
x84 XOR12 COUT11b COUT11 SUM12b VDD VSS XNOR12 alu_2x1_mux
x85 VDD VSS A13 B13p OR12 SUM_113b COUT_113 alu_full_adder_kSUMb_1_kTS_1
x86 VDD VSS A14 B14p COUT_113 SUM_114b COUT_114 alu_full_adder_kSUMb_1_kTS_1
x87 VDD VSS A15 B15p COUT_114 SUM_115b COUT_115 alu_full_adder_kSUMb_1_kTS_1
x88 VDD VSS SEL0 SEL1 SA SB SC SD 2x4_decoder
x89 XOR15 XOR14 XOR13 XOR12 XOR11 XOR10 XOR9 XOR8 XOR7 XOR6 XOR5 XOR4 XOR3 XOR2 XOR1 XOR0 VDD Z VSS and16
x91 COUT_115 COUT11b COUT11 COUT15 VDD VSS COUT_015 COUT15b alu_2x1_mux_cmos_kI_2p5_kY_2p15278_kYb_1p875
x94 COUT_014 COUT11 COUT11b COUT14 VDD VSS COUT_114 COUT14b alu_2x1_mux_cmos_kI_2p5_kY_2p15278_kYb_1p875
x93 VDD F COUT14 COUT15 VSS xor2
x95 VDD N F Y15 VSS xor2
x1215 VDD B15p B15 CIN VSS xor2
x1214 VDD B14p B14 CIN VSS xor2
x1213 VDD B13p B13 CIN VSS xor2
x1212 VDD B12p B12 CIN VSS xor2
x1211 VDD B11p B11 CIN VSS xor2
x1210 VDD B10p B10 CIN VSS xor2
x129 VDD B9p B9 CIN VSS xor2
x128 VDD B8p B8 CIN VSS xor2
x127 VDD B7p B7 CIN VSS xor2
x126 VDD B6p B6 CIN VSS xor2
x125 VDD B5p B5 CIN VSS xor2
x124 VDD B4p B4 CIN VSS xor2
x123 VDD B3p B3 CIN VSS xor2
x122 VDD B2p B2 CIN VSS xor2
x121 VDD B1p B1 CIN VSS xor2
x120 VDD B0p B0 CIN VSS xor2
**** begin user architecture code
**** end user architecture code
.ends

.subckt alu_full_adder_kSUMb_1_kTS_1 VDD VSS A B CIN SUMb COUT
*.PININFO VDD:B VSS:B A:I B:I CIN:I SUMb:O COUT:O
M1 net1 B VDD VDD pfet_03v3 L=0.28u W=0.72u nf=1 m=1
M2 net4 A net1 VDD pfet_03v3 L=0.28u W=0.72u nf=1 m=1
M3 net3 A VDD VDD pfet_03v3 L=0.28u W=0.72u nf=1 m=1
M4 net3 B VDD VDD pfet_03v3 L=0.28u W=0.72u nf=1 m=1
M5 net4 CIN net3 VDD pfet_03v3 L=0.28u W=0.72u nf=1 m=1
M6 net4 CIN net5 VSS nfet_03v3 L=0.28u W=0.36u nf=1 m=1
M7 net2 B VSS VSS nfet_03v3 L=0.28u W=0.36u nf=1 m=1
M8 net4 A net2 VSS nfet_03v3 L=0.28u W=0.36u nf=1 m=1
M9 net5 A VSS VSS nfet_03v3 L=0.28u W=0.36u nf=1 m=1
M10 net5 B VSS VSS nfet_03v3 L=0.28u W=0.36u nf=1 m=1
M11 SUMb net4 net7 VDD pfet_03v3 L=0.28u W=0.72u nf=1 m=1
M12 net7 A VDD VDD pfet_03v3 L=0.28u W=0.72u nf=1 m=1
M13 net7 CIN VDD VDD pfet_03v3 L=0.28u W=0.72u nf=1 m=1
M14 net7 B VDD VDD pfet_03v3 L=0.28u W=0.72u nf=1 m=1
M15 net8 A net9 VDD pfet_03v3 L=0.28u W=0.72u nf=1 m=1
M16 SUMb CIN net8 VDD pfet_03v3 L=0.28u W=0.72u nf=1 m=1
M17 net9 B VDD VDD pfet_03v3 L=0.28u W=0.72u nf=1 m=1
M18 SUMb net4 net6 VSS nfet_03v3 L=0.28u W=0.36u nf=1 m=1
M19 net6 B VSS VSS nfet_03v3 L=0.28u W=0.36u nf=1 m=1
M20 net6 A VSS VSS nfet_03v3 L=0.28u W=0.36u nf=1 m=1
M21 net6 CIN VSS VSS nfet_03v3 L=0.28u W=0.36u nf=1 m=1
M22 SUMb CIN net11 VSS nfet_03v3 L=0.28u W=0.36u nf=1 m=1
M23 net11 A net10 VSS nfet_03v3 L=0.28u W=0.36u nf=1 m=1
M24 net10 B VSS VSS nfet_03v3 L=0.28u W=0.36u nf=1 m=1
M25 COUT net4 VDD VDD pfet_03v3 L=0.28u W=0.72u nf=1 m=1
M26 COUT net4 VSS VSS nfet_03v3 L=0.28u W=0.36u nf=1 m=1
**** begin user architecture code
**** end user architecture code
.ends

.subckt logic NOR VDD VSS XNOR A B NAND XOR
*.PININFO VSS:B VDD:B A:I B:I NAND:O NOR:O XNOR:O XOR:O
x1 VDD NAND A B VSS alu_nand2
x3 VDD NOR net1 VSS alu_inv
x2 VDD NOR A B VSS alu_nor2
x4 VDD XNOR NAND net1 VSS alu_nand2
x6 VDD XNOR XOR VSS alu_inv
.ends

.subckt alu_nand2 VDD OUT IN0 IN1 VSS
*.PININFO VSS:B VDD:B IN0:I IN1:I OUT:O
M1 net1 IN1 VSS VSS nfet_03v3 L=0.28u W=0.72u nf=1 m=1
M2 OUT IN0 net1 VSS nfet_03v3 L=0.28u W=0.72u nf=1 m=1
M3 OUT IN1 VDD VDD pfet_03v3 L=0.28u W=0.72u nf=1 m=1
M4 OUT IN0 VDD VDD pfet_03v3 L=0.28u W=0.72u nf=1 m=1
.ends

.subckt alu_inv VDD IN OUT VSS
*.PININFO IN:I OUT:O VDD:B VSS:B
M1 OUT IN VDD VDD pfet_03v3 L=0.28u W=0.72u nf=1 m=1
M2 OUT IN VSS VSS nfet_03v3 L=0.28u W=0.36u nf=1 m=1
.ends

.subckt alu_nor2 VDD OUT IN0 IN1 VSS
*.PININFO VSS:B VDD:B IN0:I IN1:I OUT:O
M1 OUT IN0 VSS VSS nfet_03v3 L=0.28u W=0.36u nf=1 m=1
M2 OUT IN1 VSS VSS nfet_03v3 L=0.28u W=0.36u nf=1 m=1
M3 net1 IN1 VDD VDD pfet_03v3 L=0.28u W=1.44u nf=1 m=1
M4 OUT IN0 net1 VDD pfet_03v3 L=0.28u W=1.44u nf=1 m=1
.ends

.subckt alu_4x1_mux SA A SB B VSS Y SC C SD D
*.PININFO A:I B:I C:I D:I Y:O VSS:B SA:I SB:I SC:I SD:I
M1 Y SA A VSS nfet_03v3 L=0.28u W=0.36u nf=1 m=1
M2 Y SB B VSS nfet_03v3 L=0.28u W=0.36u nf=1 m=1
M3 Y SC C VSS nfet_03v3 L=0.28u W=0.36u nf=1 m=1
M4 Y SD D VSS nfet_03v3 L=0.28u W=0.36u nf=1 m=1
.ends

.subckt logic_extended AND XOR OR NOR VDD VSS XNOR A B NAND
*.PININFO VSS:B VDD:B A:I B:I NAND:O NOR:O XNOR:O OR:O AND:O XOR:O
x1 VDD NAND A B VSS alu_nand2
x3 VDD NOR OR VSS alu_inv
x2 VDD NOR A B VSS alu_nor2
x4 VDD XNOR NAND OR VSS alu_nand2
x5 VDD NAND AND VSS alu_inv
x6 VDD XNOR XOR VSS alu_inv
.ends

.subckt alu_2x1_mux A SEL SELb Y VDD VSS B
*.PININFO A:I B:I SEL:I Y:O VDD:B VSS:B SELb:I
M1 Y SEL B VSS nfet_03v3 L=0.28u W=0.36u nf=1 m=1
M2 Y SELb B VDD pfet_03v3 L=0.28u W=0.36u nf=1 m=1
M3 Y SELb A VSS nfet_03v3 L=0.28u W=0.36u nf=1 m=1
M4 Y SEL A VDD pfet_03v3 L=0.28u W=0.36u nf=1 m=1
.ends

.subckt alu_2x1_mux_cmos_kI_2p5_kY_2p15278_kYb_1p875 A SEL SELb Y VDD VSS B Yb
*.PININFO A:I B:I SEL:I Y:O VDD:B VSS:B SELb:I Yb:O
M1 VSS B net1 VSS nfet_03v3 L=0.28u W=0.9u nf=1 m=1
M2 net1 SEL Yb VSS nfet_03v3 L=0.28u W=0.675u nf=1 m=1
M3 Yb SELb net2 VSS nfet_03v3 L=0.28u W=0.675u nf=1 m=1
M4 net2 A VSS VSS nfet_03v3 L=0.28u W=0.9u nf=1 m=1
M5 net3 SELb Yb VDD pfet_03v3 L=0.28u W=1.35u nf=1 m=1
M6 VDD B net3 VDD pfet_03v3 L=0.28u W=1.8u nf=1 m=1
M7 net4 A VDD VDD pfet_03v3 L=0.28u W=1.8u nf=1 m=1
M8 Yb SEL net4 VDD pfet_03v3 L=0.28u W=1.35u nf=1 m=1
M9 VSS Yb Y VSS nfet_03v3 L=0.28u W=0.775u nf=1 m=1
M10 VDD Yb Y VDD pfet_03v3 L=0.28u W=1.55u nf=1 m=1
**** begin user architecture code
**** end user architecture code
.ends

.subckt 2x4_decoder VDD VSS S0 S1 SA SB SC SD
*.PININFO S0:I S1:I SA:O SB:O SC:O SD:O VSS:B VDD:B
M1 S1bar S1 VSS VSS nfet_03v3 L=0.28u W=0.36u nf=1 m=1
M2 S1bar S1 VDD VDD pfet_03v3 L=0.28u W=0.72u nf=1 m=1
M3 SA S0 VSS VSS nfet_03v3 L=0.28u W=0.36u nf=1 m=1
M4 SA S1 VSS VSS nfet_03v3 L=0.28u W=0.36u nf=1 m=1
M5 SA S0 S1bar VDD pfet_03v3 L=0.28u W=0.36u nf=1 m=1
M9 S0 S1 SB VDD pfet_03v3 L=0.28u W=0.36u nf=1 m=1
M10 S0 S1bar SB VSS nfet_03v3 L=0.28u W=0.36u nf=1 m=1
M11 VSS S1 SB VSS nfet_03v3 L=0.28u W=0.36u nf=1 m=1
M12 S0 S1bar SD VDD pfet_03v3 L=0.28u W=0.36u nf=1 m=1
M13 S0 S1 SD VSS nfet_03v3 L=0.28u W=0.36u nf=1 m=1
M14 VSS S1bar SD VSS nfet_03v3 L=0.28u W=0.36u nf=1 m=1
M6 SC S0 VSS VSS nfet_03v3 L=0.28u W=0.36u nf=1 m=1
M7 SC S1bar VSS VSS nfet_03v3 L=0.28u W=0.36u nf=1 m=1
M8 SC S0 S1 VDD pfet_03v3 L=0.28u W=0.36u nf=1 m=1
.ends

.subckt and16 IN15 IN14 IN13 IN12 IN11 IN10 IN9 IN8 IN7 IN6 IN5 IN4 IN3 IN2 IN1 IN0 VDD OUT VSS
*.PININFO VSS:B VDD:B IN[15..0]:I OUT:O
x1 net4 VSS VDD IN0 IN1 IN2 IN3 nand4
x2 net1 VSS VDD IN4 IN5 IN6 IN7 nand4
x3 net2 VSS VDD IN8 IN9 IN10 IN11 nand4
x4 net3 VSS VDD IN12 IN13 IN14 IN15 nand4
x5 OUT VSS VDD net4 net1 net2 net3 nor4
.ends

.subckt nand4 OUT VSS VDD IN0 IN1 IN2 IN3
*.PININFO VSS:B VDD:B IN0:I IN1:I OUT:O IN2:I IN3:I
M1 net1 IN2 net2 VSS nfet_03v3 L=0.28u W=1.44u nf=1 m=1
M2 OUT IN3 net1 VSS nfet_03v3 L=0.28u W=1.44u nf=1 m=1
M3 OUT IN1 VDD VDD pfet_03v3 L=0.28u W=0.72u nf=1 m=1
M4 OUT IN2 VDD VDD pfet_03v3 L=0.28u W=0.72u nf=1 m=1
M5 OUT IN0 VDD VDD pfet_03v3 L=0.28u W=0.72u nf=1 m=1
M6 OUT IN3 VDD VDD pfet_03v3 L=0.28u W=0.72u nf=1 m=1
M7 net3 IN0 VSS VSS nfet_03v3 L=0.28u W=1.44u nf=1 m=1
M8 net2 IN1 net3 VSS nfet_03v3 L=0.28u W=1.44u nf=1 m=1
.ends

.subckt nor4 OUT VSS VDD IN0 IN1 IN2 IN3
*.PININFO VSS:B VDD:B IN0:I IN1:I OUT:O IN2:I IN3:I
M1 net1 IN1 net2 VDD pfet_03v3 L=0.28u W=2.88u nf=1 m=1
M2 net2 IN0 VDD VDD pfet_03v3 L=0.28u W=2.88u nf=1 m=1
M3 OUT IN1 VSS VSS nfet_03v3 L=0.28u W=0.36u nf=1 m=1
M4 OUT IN2 VSS VSS nfet_03v3 L=0.28u W=0.36u nf=1 m=1
M5 OUT IN0 VSS VSS nfet_03v3 L=0.28u W=0.36u nf=1 m=1
M6 OUT IN3 VSS VSS nfet_03v3 L=0.28u W=0.36u nf=1 m=1
M7 OUT IN3 net3 VDD pfet_03v3 L=0.28u W=2.88u nf=1 m=1
M8 net3 IN2 net1 VDD pfet_03v3 L=0.28u W=2.88u nf=1 m=1
.ends
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
