mgyee/engn1600-team1/CAD7/lib.spice

* CPU_PERIPHERALS
* Instantiation
acpu_peripherals [ clk alu_z alu_n alu_f instr15 instr14 instr13 instr12 instr11 instr10 instr9 instr8 instr7 instr6 instr5 instr4 instr3 instr2 instr1 instr0 dmem_addr15 dmem_addr14 dmem_addr13 dmem_addr12 dmem_addr11 dmem_addr10 dmem_addr9 dmem_addr8 dmem_addr7 dmem_addr6 dmem_addr5 dmem_addr4 dmem_addr3 dmem_addr2 dmem_addr1 dmem_addr0 rdst15 rdst14 rdst13 rdst12 rdst11 rdst10 rdst9 rdst8 rdst7 rdst6 rdst5 rdst4 rdst3 rdst2 rdst1 rdst0 pc15 pc14 pc13 pc12 pc11 pc10 pc9 pc8 pc7 pc6 pc5 pc4 pc3 pc2 pc1 pc0 ] [ reg_write alu_sel1 alu_sel0 alu_src_b alu_src_a alu_cin extend shift_val_src is_lui shift_amt_src mem_write data_out3 data_out2 data_out1 data_out0 pc_br pc_jmp ra15 ra14 ra13 ra12 ra11 ra10 ra9 ra8 ra7 ra6 ra5 ra4 ra3 ra2 ra1 ra0 rb15 rb14 rb13 rb12 rb11 rb10 rb9 rb8 rb7 rb6 rb5 rb4 rb3 rb2 rb1 rb0 we15 we14 we13 we12 we11 we10 we9 we8 we7 we6 we5 we4 we3 we2 we1 we0 dmem_q15 dmem_q14 dmem_q13 dmem_q12 dmem_q11 dmem_q10 dmem_q9 dmem_q8 dmem_q7 dmem_q6 dmem_q5 dmem_q4 dmem_q3 dmem_q2 dmem_q1 dmem_q0 imem_q15 imem_q14 imem_q13 imem_q12 imem_q11 imem_q10 imem_q9 imem_q8 imem_q7 imem_q6 imem_q5 imem_q4 imem_q3 imem_q2 imem_q1 imem_q0 ] null cpu_peripherals
.model cpu_peripherals d_cosim simulation="/foss/designs/engn1600-team1/CAD7/cpu_peripherals.so" delay=10p irreversible=2

* Termination
Rcpu_peripherals_clk clk 0 1G
Rcpu_peripherals_alu_z alu_z 0 1G
Rcpu_peripherals_alu_n alu_n 0 1G
Rcpu_peripherals_alu_f alu_f 0 1G
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
Rcpu_peripherals_imem_q6 imem_q6 0 1G
Rcpu_peripherals_imem_q5 imem_q5 0 1G
Rcpu_peripherals_imem_q4 imem_q4 0 1G
Rcpu_peripherals_imem_q3 imem_q3 0 1G
Rcpu_peripherals_imem_q2 imem_q2 0 1G
Rcpu_peripherals_imem_q1 imem_q1 0 1G
Rcpu_peripherals_imem_q0 imem_q0 0 1G
