mgyee/engn1600-team1/CAD6/pc.spice

** sch_path: /foss/designs/engn1600-team1/CAD6/pc.sch
.subckt pc VDD VSS CLK RSTn BR DISP7 DISP6 DISP5 DISP4 DISP3 DISP2 DISP1 DISP0 JMP DEST15 DEST14 DEST13 DEST12 DEST11 DEST10 DEST9
+ DEST8 DEST7 DEST6 DEST5 DEST4 DEST3 DEST2 DEST1 DEST0 SI SE PC15 PC14 PC13 PC12 PC11 PC10 PC9 PC8 PC7 PC6 PC5 PC4 PC3 PC2 PC1 PC0
*.PININFO JMP:I BR:I VDD:B DISP[7..0]:I PC[15..0]:O SI:I SE:I DEST[15..0]:I VSS:B CLK:I RSTn:I
x1 VDD VSS DISP_SE DISP7 sign_extend
x215 VSS BR BR15b B15 VDD VSS DISP_SE 2x1_mux
x214 VSS BR BR14b B14 VDD VSS DISP_SE 2x1_mux
x213 VSS BR BR13b B13 VDD VSS DISP_SE 2x1_mux
x212 VSS BR BR12b B12 VDD VSS DISP_SE 2x1_mux
x211 VSS BR BR11b B11 VDD VSS DISP_SE 2x1_mux
x210 VSS BR BR10b B10 VDD VSS DISP_SE 2x1_mux
x29 VSS BR BR9b B9 VDD VSS DISP_SE 2x1_mux
x28 VSS BR BR8b B8 VDD VSS DISP_SE 2x1_mux
x27 VSS BR BR7b B7 VDD VSS DISP_SE 2x1_mux
x26 VSS BR BR6b B6 VDD VSS DISP6 2x1_mux
x25 VSS BR BR5b B5 VDD VSS DISP5 2x1_mux
x24 VSS BR BR4b B4 VDD VSS DISP4 2x1_mux
x23 VSS BR BR3b B3 VDD VSS DISP3 2x1_mux
x22 VSS BR BR2b B2 VDD VSS DISP2 2x1_mux
x21 VDD BR BR1b B1 VDD VSS DISP1 2x1_mux
x20 VSS BR BR0b B0 VDD VSS DISP0 2x1_mux
x815 VDD BR BR15b VSS inv kINV=1
x814 VDD BR BR14b VSS inv kINV=1
x813 VDD BR BR13b VSS inv kINV=1
x812 VDD BR BR12b VSS inv kINV=1
x811 VDD BR BR11b VSS inv kINV=1
x810 VDD BR BR10b VSS inv kINV=1
x89 VDD BR BR9b VSS inv kINV=1
x88 VDD BR BR8b VSS inv kINV=1
x87 VDD BR BR7b VSS inv kINV=1
x86 VDD BR BR6b VSS inv kINV=1
x85 VDD BR BR5b VSS inv kINV=1
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
x76 PCJ6 SE SE6b PC_NEXT6 VDD VSS PC5 2x1_mux
x75 PCJ5 SE SE5b PC_NEXT5 VDD VSS PC4 2x1_mux
x74 PCJ4 SE SE4b PC_NEXT4 VDD VSS PC3 2x1_mux
x73 PCJ3 SE SE3b PC_NEXT3 VDD VSS PC2 2x1_mux
x72 PCJ2 SE SE2b PC_NEXT2 VDD VSS PC1 2x1_mux
x71 PCJ1 SE SE1b PC_NEXT1 VDD VSS PC0 2x1_mux
x70 PCJ0 SE SE0b PC_NEXT0 VDD VSS SI 2x1_mux
x1015 VDD SE SE15b VSS inv kINV=1
x1014 VDD SE SE14b VSS inv kINV=1
x1013 VDD SE SE13b VSS inv kINV=1
x1012 VDD SE SE12b VSS inv kINV=1
x1011 VDD SE SE11b VSS inv kINV=1
x1010 VDD SE SE10b VSS inv kINV=1
x109 VDD SE SE9b VSS inv kINV=1
x108 VDD SE SE8b VSS inv kINV=1
x107 VDD SE SE7b VSS inv kINV=1
x106 VDD SE SE6b VSS inv kINV=1
x105 VDD SE SE5b VSS inv kINV=1
x104 VDD SE SE4b VSS inv kINV=1
x103 VDD SE SE3b VSS inv kINV=1
x102 VDD SE SE2b VSS inv kINV=1
x101 VDD SE SE1b VSS inv kINV=1
x100 VDD SE SE0b VSS inv kINV=1
**** begin user architecture code


.param kINV=1
.param kSUMb=1
.param kTS=1
.param Kb=1


**** end user architecture code
.ends

* expanding   symbol:  engn1600-team1/CAD6/sign_extend.sym # of pins=4
** sym_path: /foss/designs/engn1600-team1/CAD6/sign_extend.sym
** sch_path: /foss/designs/engn1600-team1/CAD6/sign_extend.sch
.subckt sign_extend VDD VSS OUT IN
*.PININFO VDD:B VSS:B IN:I OUT:O
M1 net1 IN VDD VDD pfet_03v3 L=0.28u W='3*0.72u' nf=1 m=1
M2 net1 IN VSS VSS nfet_03v3 L=0.28u W='3*0.36u' nf=1 m=1
M3 OUT net1 VDD VDD pfet_03v3 L=0.28u W='9*0.72u' nf=1 m=1
M4 OUT net1 VSS VSS nfet_03v3 L=0.28u W='9*0.36u' nf=1 m=1
.ends


* expanding   symbol:  engn1600-team1/CAD6/pc_2x1_mux.sym # of pins=7
** sym_path: /foss/designs/engn1600-team1/CAD6/pc_2x1_mux.sym
** sch_path: /foss/designs/engn1600-team1/CAD6/pc_2x1_mux.sch
.subckt 2x1_mux A SEL SELb Y VDD VSS B
*.PININFO A:I B:I SEL:I Y:O VDD:B VSS:B SELb:I
M1 Y SEL B VSS nfet_03v3 L=0.28u W=0.36u nf=1 m=1
M2 Y SELb B VDD pfet_03v3 L=0.28u W=0.36u nf=1 m=1
M3 Y SELb A VSS nfet_03v3 L=0.28u W=0.36u nf=1 m=1
M4 Y SEL A VDD pfet_03v3 L=0.28u W=0.36u nf=1 m=1
.ends


* expanding   symbol:  engn1600-team1/CAD6/pc_inv.sym # of pins=4
** sym_path: /foss/designs/engn1600-team1/CAD6/pc_inv.sym
** sch_path: /foss/designs/engn1600-team1/CAD6/pc_inv.sch
.subckt inv VDD IN OUT VSS  kINV=1
*.PININFO IN:I OUT:O VDD:B VSS:B
M1 OUT IN VDD VDD pfet_03v3 L=0.28u W='1*0.72u' nf=1 m=1
M2 OUT IN VSS VSS nfet_03v3 L=0.28u W='1*0.36u' nf=1 m=1
**** begin user architecture code


.param kINV=1


**** end user architecture code
.ends


* expanding   symbol:  engn1600-team1/CAD6/pc_dff.sym # of pins=7
** sym_path: /foss/designs/engn1600-team1/CAD6/pc_dff.sym
** sch_path: /foss/designs/engn1600-team1/CAD6/pc_dff.sch
.subckt dff CLKb D Q RSTn CLK VDD VSS
*.PININFO D:I Q:O RSTn:I CLK:I CLKb:I VDD:B VSS:B
M7 net2 CLK VDD VDD pfet_03v3 L=0.28u W=0.36u nf=1 m=1
M8 net1 D net2 VDD pfet_03v3 L=0.28u W=0.36u nf=1 m=1
M9 net1 D net3 VSS nfet_03v3 L=0.28u W=0.36u nf=1 m=1
M10 net3 CLKb VSS VSS nfet_03v3 L=0.28u W=0.36u nf=1 m=1
M13 net4 net1 VDD VDD pfet_03v3 L=0.28u W=0.36u nf=1 m=1
M14 net4 net1 VSS VSS nfet_03v3 L=0.28u W=0.36u nf=1 m=1
M15 net1 CLKb net5 VDD pfet_03v3 L=0.28u W=0.36u nf=1 m=1
M16 net1 CLK net5 VSS nfet_03v3 L=0.28u W=0.36u nf=1 m=1
M25 net5 RSTn VDD VDD pfet_03v3 L=0.28u W=0.36u nf=1 m=1
M26 net5 net4 VDD VDD pfet_03v3 L=0.28u W=0.36u nf=1 m=1
M27 net6 net4 VSS VSS nfet_03v3 L=0.28u W=0.36u nf=1 m=1
M28 net5 RSTn net6 VSS nfet_03v3 L=0.28u W=0.36u nf=1 m=1
M29 net4 CLKb net7 VDD pfet_03v3 L=0.28u W=0.36u nf=1 m=1
M30 net4 CLK net7 VSS nfet_03v3 L=0.28u W=0.36u nf=1 m=1
M31 net8 net7 VDD VDD pfet_03v3 L=0.28u W=0.36u nf=1 m=1
M32 net8 RSTn VDD VDD pfet_03v3 L=0.28u W=0.36u nf=1 m=1
M33 net9 RSTn VSS VSS nfet_03v3 L=0.28u W=0.36u nf=1 m=1
M34 net8 net7 net9 VSS nfet_03v3 L=0.28u W=0.36u nf=1 m=1
M35 net10 CLK VDD VDD pfet_03v3 L=0.28u W=0.36u nf=1 m=1
M36 net7 net8 net10 VDD pfet_03v3 L=0.28u W=0.36u nf=1 m=1
M37 net7 net8 net11 VSS nfet_03v3 L=0.28u W=0.36u nf=1 m=1
M38 net11 CLKb VSS VSS nfet_03v3 L=0.28u W=0.36u nf=1 m=1
M43 Q net8 VDD VDD pfet_03v3 L=0.28u W=0.72u nf=1 m=1
M44 Q net8 VSS VSS nfet_03v3 L=0.28u W=0.36u nf=1 m=1
.ends


* expanding   symbol:  engn1600-team1/CAD6/pc_full_adder.sym # of pins=7
** sym_path: /foss/designs/engn1600-team1/CAD6/pc_full_adder.sym
** sch_path: /foss/designs/engn1600-team1/CAD6/pc_full_adder.sch
.subckt full_adder VDD VSS A B CIN SUM COUT  kSUMb=1 kTS=1
*.PININFO VDD:B VSS:B A:I B:I CIN:I COUT:O SUM:O
M1 net1 B VDD VDD pfet_03v3 L=0.28u W=0.72u nf=1 m=1
M2 net4 A net1 VDD pfet_03v3 L=0.28u W=0.72u nf=1 m=1
M3 net3 A VDD VDD pfet_03v3 L=0.28u W=0.72u nf=1 m=1
M4 net3 B VDD VDD pfet_03v3 L=0.28u W=0.72u nf=1 m=1
M5 net4 CIN net3 VDD pfet_03v3 L=0.28u W=0.72u nf=1 m=1
M6 net4 CIN net5 VSS nfet_03v3 L=0.28u W=0.36u nf=1 m=1
M7 net2 B VSS VSS nfet_03v3 L=0.28u W=0.36u nf=1 m=1
M8 net4 A net2 VSS nfet_03v3 L=0.28u W=0.36u nf=1 m=1
M9 net5 A VSS VSS nfet_03v3 L=0.28u W=0.36u nf=1 m=1
M10 net5 B VSS VSS nfet_03v3 L=0.28u W=0.36u nf=1 m=1
M11 net8 net4 net7 VDD pfet_03v3 L=0.28u W='1*0.72u' nf=1 m=1
M12 net7 A VDD VDD pfet_03v3 L=0.28u W=0.72u nf=1 m=1
M13 net7 CIN VDD VDD pfet_03v3 L=0.28u W=0.72u nf=1 m=1
M14 net7 B VDD VDD pfet_03v3 L=0.28u W=0.72u nf=1 m=1
M15 net9 A net10 VDD pfet_03v3 L=0.28u W=0.72u nf=1 m=1
M16 net8 CIN net9 VDD pfet_03v3 L=0.28u W='1*0.72u' nf=1 m=1
M17 net10 B VDD VDD pfet_03v3 L=0.28u W=0.72u nf=1 m=1
M18 net8 net4 net6 VSS nfet_03v3 L=0.28u W='1*0.36u' nf=1 m=1
M19 net6 B VSS VSS nfet_03v3 L=0.28u W=0.36u nf=1 m=1
M20 net6 A VSS VSS nfet_03v3 L=0.28u W=0.36u nf=1 m=1
M21 net6 CIN VSS VSS nfet_03v3 L=0.28u W=0.36u nf=1 m=1
M22 net8 CIN net12 VSS nfet_03v3 L=0.28u W='1*0.36u' nf=1 m=1
M23 net12 A net11 VSS nfet_03v3 L=0.28u W=0.36u nf=1 m=1
M24 net11 B VSS VSS nfet_03v3 L=0.28u W=0.36u nf=1 m=1
M25 COUT net4 VDD VDD pfet_03v3 L=0.28u W=0.72u nf=1 m=1
M26 COUT net4 VSS VSS nfet_03v3 L=0.28u W=0.36u nf=1 m=1
**** begin user architecture code


.param kSUMb=1
.param kTS=1


**** end user architecture code
M27 SUM net8 VDD VDD pfet_03v3 L=0.28u W=0.72u nf=1 m=1
M28 SUM net8 VSS VSS nfet_03v3 L=0.28u W=0.36u nf=1 m=1
.ends
