mgyee/engn1600-team1/CAD3/rf_WECLK.spice

** sch_path: /foss/designs/engn1600-team1/CAD3/rf_WECLK.sch
.subckt rf_WECLK RA15 RA14 RA13 RA12 RA11 RA10 RA9 RA8 RA7 RA6 RA5 RA4 RA3 RA2 RA1 RA0 RB15 RB14 RB13 RB12 RB11 RB10 RB9 RB8 RB7
+ RB6 RB5 RB4 RB3 RB2 RB1 RB0 WE15 WE14 WE13 WE12 WE11 WE10 WE9 WE8 WE7 WE6 WE5 WE4 WE3 WE2 WE1 WE0 CLK WEM D15 D14 D13 D12 D11 D10 D9
+ D8 D7 D6 D5 D4 D3 D2 D1 D0 VDD VSS QA15b QA14b QA13b QA12b QA11b QA10b QA9b QA8b QA7b QA6b QA5b QA4b QA3b QA2b QA1b QA0b QB15b QB14b
+ QB13b QB12b QB11b QB10b QB9b QB8b QB7b QB6b QB5b QB4b QB3b QB2b QB1b QB0b WE0CLKtest
*.PININFO RA[15..0]:I RB[15..0]:I WE[15..0]:I CLK:I WEM:I D[15..0]:I VDD:B VSS:B QA[15..0]b:O QB[15..0]b:O WE0CLKtest:O
x0_0 VDD VSS QA0 WE0CLK WE0CLKb RA0 RB0 QB0 N0 slave_latch kQ='kQ'
x0_1 VDD VSS QA1 WE0CLK WE0CLKb RA0 RB0 QB1 N1 slave_latch kQ='kQ'
x0_2 VDD VSS QA2 WE0CLK WE0CLKb RA0 RB0 QB2 N2 slave_latch kQ='kQ'
x0_3 VDD VSS QA3 WE0CLK WE0CLKb RA0 RB0 QB3 N3 slave_latch kQ='kQ'
x0_4 VDD VSS QA4 WE0CLK WE0CLKb RA0 RB0 QB4 N4 slave_latch kQ='kQ'
x0_5 VDD VSS QA5 WE0CLK WE0CLKb RA0 RB0 QB5 N5 slave_latch kQ='kQ'
x0_6 VDD VSS QA6 WE0CLK WE0CLKb RA0 RB0 QB6 N6 slave_latch kQ='kQ'
x0_7 VDD VSS QA7 WE0CLK WE0CLKb RA0 RB0 QB7 N7 slave_latch kQ='kQ'
x0_8 VDD VSS QA8 WE0CLK WE0CLKb RA0 RB0 QB8 N8 slave_latch kQ='kQ'
x0_9 VDD VSS QA9 WE0CLK WE0CLKb RA0 RB0 QB9 N9 slave_latch kQ='kQ'
x0_10 VDD VSS QA10 WE0CLK WE0CLKb RA0 RB0 QB10 N10 slave_latch kQ='kQ'
x0_11 VDD VSS QA11 WE0CLK WE0CLKb RA0 RB0 QB11 N11 slave_latch kQ='kQ'
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
x29 CLK WE3 WE3CLKb VDD VSS WE3CLK driver_cell kWECLK='kWECLK' kWECLKb='kWECLKb'
x30 CLK WE2 WE2CLKb VDD VSS WE2CLK driver_cell kWECLK='kWECLK' kWECLKb='kWECLKb'
x31 CLK WE1 WE1CLKb VDD VSS WE1CLK driver_cell kWECLK='kWECLK' kWECLKb='kWECLKb'
x32 CLK WE0 WE0CLKb VDD VSS WE0CLK driver_cell kWECLK='kWECLK' kWECLKb='kWECLKb'
x33 VDD VSS QA0b QA0 QB0 QB0b output_inverter
x34 VDD VSS QA1b QA1 QB1 QB1b output_inverter
x35 VDD VSS QA2b QA2 QB2 QB2b output_inverter
x36 VDD VSS QA3b QA3 QB3 QB3b output_inverter
x37 VDD VSS QA4b QA4 QB4 QB4b output_inverter
x38 VDD VSS QA5b QA5 QB5 QB5b output_inverter
x39 VDD VSS QA6b QA6 QB6 QB6b output_inverter
x40 VDD VSS QA7b QA7 QB7 QB7b output_inverter
x41 VDD VSS QA8b QA8 QB8 QB8b output_inverter
x42 VDD VSS QA9b QA9 QB9 QB9b output_inverter
x43 VDD VSS QA10b QA10 QB10 QB10b output_inverter
x44 VDD VSS QA11b QA11 QB11 QB11b output_inverter
x45 VDD VSS QA12b QA12 QB12 QB12b output_inverter
x46 VDD VSS QA13b QA13 QB13 QB13b output_inverter
x47 VDD VSS QA14b QA14 QB14 QB14b output_inverter
x48 VDD VSS QA15b QA15 QB15 QB15b output_inverter
x49 VDD WEM WEMb VSS wem_inverter kWEMb='kWEMb'
**** begin user architecture code


.param kWECLKb=1.34/0.36
.param kWECLK=1.27/0.36
.param kWEMb=1.26/0.36
.param kQ=0.36/0.36
.param kN=1.24/0.36


**** end user architecture code
.ends

* expanding   symbol:  engn1600-team1/CAD3/slave_latch.sym # of pins=9
** sym_path: /foss/designs/engn1600-team1/CAD3/slave_latch.sym
** sch_path: /foss/designs/engn1600-team1/CAD3/slave_latch.sch
.subckt slave_latch VDD VSS QA WECLK WECLKb RA RB QB D  kQ=1
*.PININFO D:I RA:I RB:I WECLKb:I WECLK:I QA:O QB:O VDD:B VSS:B
M1 net1 WECLKb net2 VDD pfet_03v3 L=0.28u W=0.36u nf=1 m=1
M2 net1 D VDD VDD pfet_03v3 L=0.28u W=0.72u nf=1 m=1
M3 net3 net2 VDD VDD pfet_03v3 L=0.28u W=0.72u nf=1 m=1
M4 net4 net2 VDD VDD pfet_03v3 L=0.28u W=0.36u nf=1 m=1
M5 VDD WECLK net8 VDD pfet_03v3 L=0.28u W=0.36u nf=1 m=1
M6 net8 net4 net2 VDD pfet_03v3 L=0.28u W=0.36u nf=1 m=1
M7 net1 D VSS VSS nfet_03v3 L=0.28u W=0.36u nf=1 m=1
M8 net1 WECLK net2 VSS nfet_03v3 L=0.28u W=0.36u nf=1 m=1
M9 net3 net2 VSS VSS nfet_03v3 L=0.28u W=0.36u nf=1 m=1
M10 net4 net2 VSS VSS nfet_03v3 L=0.28u W=0.36u nf=1 m=1
M11 net7 net4 net2 VSS nfet_03v3 L=0.28u W=0.36u nf=1 m=1
M12 VSS WECLKb net7 VSS nfet_03v3 L=0.28u W=0.36u nf=1 m=1
M13 net3 net5 QB VDD pfet_03v3 L=0.28u W='0.36/0.36*0.36u' nf=1 m=1
M14 net3 RB QB VSS nfet_03v3 L=0.28u W='0.36/0.36*0.36u' nf=1 m=1
M15 net5 RB VDD VDD pfet_03v3 L=0.28u W=0.72u nf=1 m=1
M16 net5 RB VSS VSS nfet_03v3 L=0.28u W=0.36u nf=1 m=1
M21 net3 net6 QA VDD pfet_03v3 L=0.28u W='0.36/0.36*0.36u' nf=1 m=1
M22 net3 RA QA VSS nfet_03v3 L=0.28u W='0.36/0.36*0.36u' nf=1 m=1
M23 net6 RA VDD VDD pfet_03v3 L=0.28u W=0.72u nf=1 m=1
M24 net6 RA VSS VSS nfet_03v3 L=0.28u W=0.36u nf=1 m=1
**** begin user architecture code


.param kQ=1


**** end user architecture code
.ends


* expanding   symbol:  engn1600-team1/CAD3/master_latch.sym # of pins=6
** sym_path: /foss/designs/engn1600-team1/CAD3/master_latch.sym
** sch_path: /foss/designs/engn1600-team1/CAD3/master_latch.sch
.subckt master_latch VDD VSS Q WEM WEMb D  kN=1
*.PININFO D:I WEMb:I WEM:I VSS:B VDD:B Q:O
M3 net1 WEMb net2 VDD pfet_03v3 L=0.28u W=0.36u nf=1 m=1
M7 net1 D VDD VDD pfet_03v3 L=0.28u W=0.72u nf=1 m=1
M8 Q net2 VDD VDD pfet_03v3 L=0.28u W='1.24/0.36*0.72u' nf=1 m=1
M9 net3 net2 VDD VDD pfet_03v3 L=0.28u W=0.36u nf=1 m=1
M10 VDD WEM net5 VDD pfet_03v3 L=0.28u W=0.36u nf=1 m=1
M12 net5 net3 net2 VDD pfet_03v3 L=0.28u W=0.36u nf=1 m=1
M19 net1 D VSS VSS nfet_03v3 L=0.28u W=0.36u nf=1 m=1
M20 net1 WEM net2 VSS nfet_03v3 L=0.28u W=0.36u nf=1 m=1
M21 Q net2 VSS VSS nfet_03v3 L=0.28u W='1.24/0.36*0.36u' nf=1 m=1
M22 net3 net2 VSS VSS nfet_03v3 L=0.28u W=0.36u nf=1 m=1
M23 net4 net3 net2 VSS nfet_03v3 L=0.28u W=0.36u nf=1 m=1
M24 VSS WEMb net4 VSS nfet_03v3 L=0.28u W=0.36u nf=1 m=1
**** begin user architecture code


.param kN=1


**** end user architecture code
.ends


* expanding   symbol:  engn1600-team1/CAD3/driver_cell.sym # of pins=6
** sym_path: /foss/designs/engn1600-team1/CAD3/driver_cell.sym
** sch_path: /foss/designs/engn1600-team1/CAD3/driver_cell.sch
.subckt driver_cell CLK WE WECLKb VDD VSS WECLK  kWECLK=1 kWECLKb=1
*.PININFO CLK:I WE:I VSS:B VDD:B WECLKb:O WECLK:O
M13 WECLK net1 VDD VDD pfet_03v3 L=0.28u W='1.27/0.36*0.72u' nf=1 m=1
M14 WECLK net1 VSS VSS nfet_03v3 L=0.28u W='1.27/0.36*0.36u' nf=1 m=1
M1 WECLKb WECLK VDD VDD pfet_03v3 L=0.28u W='1.34/0.36*0.72u' nf=1 m=1
M2 WECLKb WECLK VSS VSS nfet_03v3 L=0.28u W='1.34/0.36*0.36u' nf=1 m=1
M3 net1 CLK VDD VDD pfet_03v3 L=0.28u W=0.72u nf=1 m=1
M4 net1 WE VDD VDD pfet_03v3 L=0.28u W=0.72u nf=1 m=1
M5 net2 WE VSS VSS nfet_03v3 L=0.28u W=0.72u nf=1 m=1
M6 net1 CLK net2 VSS nfet_03v3 L=0.28u W=0.72u nf=1 m=1
**** begin user architecture code


.param kWECLKb=1
.param kWECLK=1


**** end user architecture code
.ends


* expanding   symbol:  engn1600-team1/CAD3/output_inverter.sym # of pins=6
** sym_path: /foss/designs/engn1600-team1/CAD3/output_inverter.sym
** sch_path: /foss/designs/engn1600-team1/CAD3/output_inverter.sch
.subckt output_inverter VDD VSS QAb QA QB QBb
*.PININFO QBb:O QAb:O VDD:B VSS:B QA:I QB:I
M3 QBb QB VDD VDD pfet_03v3 L=0.28u W=0.72u nf=1 m=1
M4 QBb QB VSS VSS nfet_03v3 L=0.28u W=0.36u nf=1 m=1
M35 QAb QA VDD VDD pfet_03v3 L=0.28u W=0.72u nf=1 m=1
M36 QAb QA VSS VSS nfet_03v3 L=0.28u W=0.36u nf=1 m=1
.ends


* expanding   symbol:  engn1600-team1/CAD3/wem_inverter.sym # of pins=4
** sym_path: /foss/designs/engn1600-team1/CAD3/wem_inverter.sym
** sch_path: /foss/designs/engn1600-team1/CAD3/wem_inverter.sch
.subckt wem_inverter VDD WEM WEMb VSS  kWEMb=1
*.PININFO WEM:I WEMb:O VDD:B VSS:B
M1 WEMb WEM VDD VDD pfet_03v3 L=0.28u W='1.26/0.36*0.72u' nf=1 m=1
M2 WEMb WEM VSS VSS nfet_03v3 L=0.28u W='1.26/0.36*0.36u' nf=1 m=1
**** begin user architecture code


.param kWEMb=1


**** end user architecture code
.ends
