mgyee/engn1600-team1/CAD7/benches/tb_memshift_jal.v

// ENGN1600 Baseline RISC Processor
// Anhang Li (anhangli@umich.edu)
// -----

`timescale 1ns/1ps
module tb_memshift_jal;
    reg clk = 0;
    reg rst = 1;
    always #5 clk = ~clk;

    processor #(.IMEM_FILE("benches/bench_memshift_jal.memh")) dut (
        .CLK(clk), .RSTn(~rst), .SI(), .SE()
    );

    initial begin
        #12 rst = 0;
        repeat (15) @(posedge clk);

        if (dut.u_dmem.mem[16'h0000] !== 16'h0010) begin
            $display("FAIL load/shift/store: mem[0] = %h, expected 0010", dut.u_dmem.mem[16'h0000]);
            $fatal;
        end
        if (dut.u_dmem.mem[16'h0001] !== 16'h0009) begin
            $display("FAIL JAL link: mem[1] = %h, expected 0009", dut.u_dmem.mem[16'h0001]);
            $fatal;
        end

        $display("PASS tb_memshift_jal");
        $finish;
    end
endmodule
