mgyee/engn1600-team1/CAD7/benches/tb_fib.v

// ENGN1600 Baseline RISC Processor
// Anhang Li (anhangli@umich.edu)
// -----

`timescale 1ns/1ps
module tb_fib;
    reg clk = 0;
    reg rst = 1;
    always #5 clk = ~clk;

    processor #(.IMEM_FILE("benches/bench_fib.memh")) dut (
        .CLK(clk), .RSTn(~rst), .SI(), .SE()
    );

    initial begin
        #12 rst = 0;
        repeat (100) @(posedge clk);

        if (dut.u_dmem.mem[16'h0000] !== 16'd55) begin
            $display("FAIL fib: mem[0] = %h, expected 0037", dut.u_dmem.mem[16'h0000]);
            $fatal;
        end

        $display("PASS tb_fib");
        $finish;
    end
endmodule
