mgyee/engn1600-team1/(commit log)

2026-02-17 add slave latch
    [slave_latch.sch]
2026-02-17 Update master latch
    [master_latch.sch, slave_latch.sch]
2026-02-17 Pin names
    [rf.sch]
2026-02-17 add slave latch to rf
    [rf.sch]
2026-02-17 add latch 2
    [rf.sch]
2026-02-17 add square
    [rf.sch]
2026-02-17 fix latch
    [rf.sch]
2026-02-17 All latches
    [rf2.sch]
2026-02-17 rf sch
    [driver_cell.sch, master_latch.sch, rf2.sch]
2026-02-18 small fix to names
    [rf2.sch, slave_latch.sch]
2026-02-18 remove rf2
    [rf.sch, rf2.sch]
2026-02-19 rf sizing sch
    [rf_sizing_tb.sch]
2026-02-20 sized slave_latch EXCEPT for QA/QB transmission gates
    [slave_latch.sch]
2026-02-20 Default transistor sizing
    [driver_cell.sch, master_latch.sch, rf.sch, rf_sizing_tb.sch, slave_latch.sch]
2026-02-22 driver_cell passes drc
2026-02-22 working driver gds
2026-02-23 driver cell lvs + drc
2026-02-23 reorder rf sch
    [rf.sch]
2026-02-23 make symbols for wem inv, output invs
    [output_inverter.sch, rf.sch, wem_inverter.sch]
2026-02-23 output inverter drc + lvs
    [output_inverter.sch]
2026-02-25 Finalized Master Latch with Sized Up Driving Inverter
    [master_latch.sch]
2026-02-25 driver cell sizing update
    [driver_cell.sch]
2026-02-25 Master Latch, reduced size with 3.45 kN
    [master_latch.sch]
2026-02-25 wem inverter done
    [wem_inverter.sch]
2026-02-26 Parameterization (#2)
    [driver_cell.sch, master_latch.sch, rf.sch, rf_sizing_tb.sch, slave_latch.sch, wem_inverter.sch]
2026-02-26 Schematic fix
    [rf.sch]
2026-02-27 Squash merge lvs into main
    [driver_cell.sch, rf.sch, rf_sizing_tb.sch]
2026-02-27 Testbench with voltage sources
    [rf_tb.sch]
2026-02-28 Label swapping & initial timing (#4)
    [output_inverter.sch, rf.sch, rf_sizing_tb.sch, rf_tb.sch, slave_latch.sch]
2026-02-28 Prepex timing (#5)
    [rf_tb.sch]
2026-02-28 Plot limits
    [rf_tb.sch]
2026-03-01 progress on adding everything to the README
    [RF_schematic.sch, rf_postPEX_tb.sch, rf_tb_pdread.sch, rf_tb_pdwrite.sch]
2026-03-01 separate testbenches for simulations
    [rf_postPEX_tb_hold_fall.sch, rf_postPEX_tb_hold_rise.sch, rf_postPEX_tb_pdread.sch, rf_postPEX_tb_pdwrite.sch, rf_postPEX_tb_setup_fall.sch, rf_postPEX_tb_setup_rise.sch, rf_tb_pdwrite (copy 1).sch, rf_tb_pdwrite (copy 2).sch]
2026-03-01 Testbenches labeled
    [rf_postPEX_tb_hold_fall.sch, rf_postPEX_tb_hold_rise.sch, rf_postPEX_tb_pdread.sch, rf_postPEX_tb_pdwrite.sch, rf_postPEX_tb_setup_fall.sch, rf_postPEX_tb_setup_rise.sch, rf_prePEX_tb_hold_fall.sch, rf_prePEX_tb_hold_rise.sch]
2026-03-01 Saving changes before switching
2026-03-01 CLK->WE0CLK delays added to main
    [rf_WECLK.sch, rf_postPEX_tbCLK->WE0CLKdelay.sch, rf_postPEX_tbWECLK.sch]
2026-03-01 Rename testbench folder
    [rf_postPEX_tbCLK->WE0CLKdelay.sch, rf_postPEX_tb_hold_fall.sch, rf_postPEX_tb_hold_rise.sch, rf_postPEX_tb_pdread.sch, rf_postPEX_tb_pdwrite.sch, rf_postPEX_tb_setup_fall.sch, rf_postPEX_tb_setup_rise.sch, rf_prePEX_tb_hold_fall.sch]
2026-03-01 Post pex (#6)
    [rf_postPEX_tb.sch]
2026-03-01 CAD4 start
    [1bit_full_adder.sch]
2026-03-01 mv to CAD4 dir
    [full_adder.sch]
2026-03-04 full adder functionality
    [full_adder.sch, full_adder_cin_0.sch, full_adder_cin_0_tb.sch, full_adder_cin_1.sch, full_adder_cin_1_tb.sch, full_adder_tb.sch]
2026-03-04 pd (slow bc needs sizing)
    [full_adder.sch, full_adder_pd_tb.sch]
2026-03-05 Logic (#7)
    [INV.sch, NAND2.sch, NOR2.sch, logic.sch, logic_extended.sch, logic_extended_tb.sch, logic_tb.sch]
2026-03-05 2:1 MUX (#9)
    [2:1_mux.sch, 2:1_mux_tb.sch, 4:1_mux.sch, 4:1_mux_tb.sch, 4TG.sch, 4TG_tb.sch]
2026-03-05 4:1 MUX (#10)
    [4:1_mux.sch, 4_pass_transisors.sch]
2026-03-05 Capitalization consistency
    [inv.sch, logic.sch, logic_extended.sch, nand2.sch, nor2.sch]
2026-03-05 4:1 MUX TB
    [2:1_mux_tb.sch, 4:1_mux_tb.sch]
2026-04-01 Alu sch (#12)
    * start alu sch
    * Decoder Added to ALU
    * Add XOR to logic
    * Add AND16
    * Fix alu
    * FN flags
    * ALU testbench
    * Plot & code
    * Bug fix
    * Remove colon
    * More colon removal
    * Add plot
    * initial logic cell layout
    * full adder layout
    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
    [2x1_mux.sch, 2x1_mux_cmos.sch, 2x1_mux_cmos_sizing_tb.sch, 2x1_mux_tb.sch, 2x4_decoder.sch, 2x4_decoder_tb.sch, 4x1_mux.sch, 4x1_mux_tb.sch]
2026-04-01 cad 5 start
2026-04-02 Basic shifter & testbench
    [2x1_mux_cmos.sch, inv.sch, shifter.sch, shifter_tb.sch]
2026-04-04 Inverting gated design
    [2x1_muxb.sch, nand2.sch, nor2.sch, shifter.sch, shifter_tb.sch]
2026-04-05 Delay testbench
    [2x1_mux_cmos.sch, 2x1_muxb.sch, shifter_delay_tb.sch]
2026-04-05 Non-inverting shifter & delay
    [shifter.sch, shifter_delay_tb.sch]
2026-04-07 Intermediate renaming
    [shifter.sch, shifter_delay_tb.sch]
2026-04-07 Split MUX sections
    [shifter.sch]
2026-04-07 Add sizing parameters
    [inv.sch, shifter.sch]
2026-04-07 Sizing testbench
    [shifter_sizing_tb.sch]
2026-04-07 Transmission gate implementation
    [2x1_mux.sch, 2x1_muxb.sch, shifter.sch]
2026-04-07 Updated testbenches
    [shifter.sch, shifter_delay_tb.sch, shifter_sizing_tb.sch, shifter_tb.sch]
2026-04-08 Full functionality verification
    [shifter_tb.sch]
2026-04-09 2x1_mux_cmos for select
    [2x1_mux_cmos.sch, shifter.sch]
2026-04-10 inserted output inverters, fixed some DRC
2026-04-10 Unit inverter
    [shifter.sch, unit_inv.sch]
2026-04-10 post-PEX testbenches
    [shifter_postpex_delay_tb.sch, shifter_postpex_tb.sch]
2026-04-11 Initial README update
    [shifter_sizing_tb.sch]
2026-04-11 Updated tests
    [shifter_postpex_tb.sch, shifter_tb.sch]
2026-04-14 more cad6
    [pc.sch, sign_extend.sch]
2026-04-15 DFF modifications
    [DFF.sch, DFF_Loop_PostPex_Testbench.sch, DFF_PostPex_SetupTime_Testbench.sch, DFF_Post_Pex_HoldTime_Testbench.sch, DFF_Testbench.sch, DFF_pc.sch, INV.sch, NAND2.sch]
2026-04-15 cad2 dff
    [cad2_dff.sch, pc.sch]
2026-04-15 mux and sign extend
    [2x1_mux.sch, inv.sch, pc.sch, sign_extend.sch]
2026-04-15 DFF schematic + layout
    [dff.sch]
2026-04-15 PC schematic
    [dff.sch, full_adder.sch, pc.sch]
2026-04-15 Bus bar consistency
    [pc.sch]
2026-04-16 Testbench progress
    [pc.sch, pc_tb.sch]
2026-04-16 Bug fix
    [pc.sch]
2026-04-16 Final fixes
    [pc_tb.sch]
2026-04-17 LVS compatibility
    [pc.sch, sign_extend.sch]
2026-04-17 Remove extraneous files
    [DFF.sch, DFF_Loop_PostPex_Testbench.sch, DFF_PostPex_SetupTime_Testbench.sch, DFF_Post_Pex_HoldTime_Testbench.sch, DFF_Testbench.sch, DFF_pc.sch, INV.sch, NAND2.sch]
2026-04-17 Initial postpex
    [pc_postpex_tb.sch]
2026-04-17 Expost PC_NEXT15
    [pc.sch, pc_postpex_delay_tb.sch]
2026-04-17 added PC_NEXT15 pin
2026-04-17 Final functionality tb
    [pc_postpex_tb.sch, pc_tb.sch]
2026-04-22 new changes to schemaic
    [datapath.sch]
2026-04-22 Lab wire to lab pin
    [datapath.sch]
2026-04-22 Datapath progress
    [2x1_mux.sch, 2x1_mux_pass.sch, 4x1_mux.sch, datapath.sch, inv.sch]
2026-04-22 sign zero extender
    [nand2.sch, sign_zero_extender.sch]
2026-04-23 control stuff in datapath
    [datapath.sch]
2026-04-23 more stuff
    [datapath.sch]
2026-04-23 Datapath netlist
    [2x1_mux_pass.sch, datapath.sch]
2026-04-23 Processor Verilog
    [datapath.sch]
2026-04-23 data out
    [datapath.sch]
2026-04-24 Shifter fix
    [datapath.sch]
2026-04-24 Control & processor syntax fixes
    [control.v]
2026-04-24 New Makefile & initial fixes
    [control.v]
2026-04-24 Datapath bind
    [datapath_bind.sch]
2026-04-25 Rename setup
    [datapath.sch]
2026-04-25 Mass renaming
    [2x1_mux_cmos_sizing_tb.sch, 2x1_mux_pass.sch, 2x1_mux_tb.sch, 4x1_mux_tb.sch, alu.sch, alu_2x1_mux.sch, alu_2x1_mux_cmos.sch, alu_4x1_mux.sch]
2026-04-26 ngspice method (#14)
    [datapath_bind.sch, processor.sch, processor_tb.sch]
2026-04-28 Testing pipeline
    [processor_tb.sch]
2026-04-29 Updated inline plots
    [processor_tb.sch]
2026-04-29 Fix & plot IMEM output
    [processor_tb.sch]
2026-04-29 Distinctive defaults
    [imem_tb.sch]
2026-04-29 Spice datapath
    [processor.sch]
2026-04-29 Move sources
    [processor_tb.sch]
2026-04-29 Back to combo imem
    [processor_tb.sch]
2026-04-30 Better vcd conversion
    [datapath.sch]
2026-05-02 fixed WEM
    [datapath.sch]
2026-05-02 DMEM fix & cleanup
    [datapath.sch]
2026-05-02 Everything's a wire
2026-05-03 wem stuff and flush
    [datapath.sch]
2026-05-03 Remove IMEM tb
    [imem_tb.sch]
2026-05-03 4x inverter
    [datapath.sch, four_inv.sch]
2026-05-03 martins version
    [datapath.sch]
2026-05-03 Cleanup, ctrl, & memory analysis (#15)
    [datapath.sch, pc.sch]
2026-05-03 Better RF write & debug
    [master_latch.sch, rf.sch, slave_latch.sch]
2026-05-03 Memshift JAL
    [datapath.sch, shifter.sch]
2026-05-05 sanity break
    [datapath.sch]
2026-05-06 martin pre lvs
    [datapath.sch]
2026-05-07 Remove extra inverters
    [alu.sch]
2026-05-07 ajdsfkla: PC word align fix & rf output inverter fix
    [spice_params.py]
2026-05-08 datapath sim
    [processor.sch]
